GoncaloRibeiro6533/Access-Control-System/docs/moduloKeyboardReader_LEIC21D_G06.pdf

Keyboard Reader (Access Control System)
Laboratório de Informática e Computadores 2022 / 2023 verão Autores: António Coelho 47236 / Gonçalo Ribeiro 48305/ Jorge Silva 49504

O módulo Keyboard Reader é constituído por três blocos principais: i) o descodificador de teclado (Key Decode); ii) o bloco de armazenamento (designado por Ring Buffer); e iii) o bloco de entrega ao consumidor (designado por Output Buffer). Neste caso o módulo Control, implementado em software, é a entidade consumidora.

Figura 1 – Diagrama de blocos do módulo Keyboard Reader

## 1 Key Decode

O bloco Key Decode implementa um descodificador de um teclado matricial 4x3 por hardware, sendo constituído por três sub-blocos: i) um teclado matricial de 4x3; ii) o bloco Key Scan, responsável pelo varrimento do teclado; e iii) o bloco Key Control, que realiza o controlo do varrimento e o controlo de fluxo, conforme o diagrama de blocos representado na Figura 2a. O controlo de fluxo de saída do bloco Key Decode (para o módulo Key Buffer), define que o sinal Kval é ativado quando é detetada a pressão de uma tecla, sendo também disponibilizado o código dessa tecla no barramento K0:3. Apenas é iniciado um novo ciclo de varrimento ao teclado quando o sinal Kack for ativado e a tecla premida for libertada. O diagrama temporal do controlo de fluxo está representado na Figura 2b.

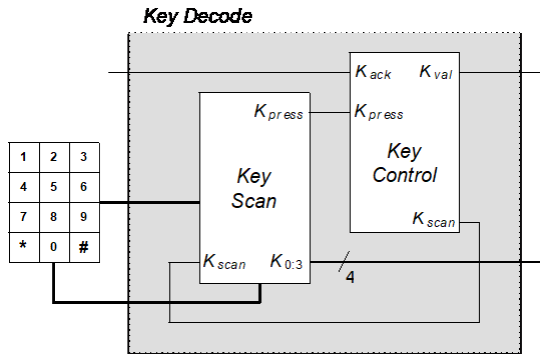
[picture p6: figure]

a) Diagrama de blocos
b) Diagrama temporal
Figura 2 – Bloco Key Decode O bloco Key Scan foi implementado de acordo com o diagrama de blocos representado na Figura 3. Na implementação do bloco Key Scan optámos pelo diagrama de blocos versão 1, uma vez que na versão 2 o Kpress fica ativo, se uma tecla for premida, independentemente da linha que esteja a ser observada.
Na versão 1, de acordo com a figura 3 este é constituído por um decoder (2 por 3), um mutiplexer (4 por 1) e um contador de 4 bits que é responsável pela seleção das saídas do decoder e das entradas do mutiplexer.
Às entradas do mutiplexer estão ligadas as linhas do teclado de forma a ativar o Kpress quando uma tecla na linha selecionada seja premida. Nas saídas do decoder encontram-se as colunas do teclado, de forma a selecionar uma linha. Quando uma tecla é premida a entrada enable do contador recebe o valor lógico 0, para que seja possível fazer a leitura do código da tecla premida, sendo os bits de maior peso a coluna da tecla foi premida e os bits de menor peso a linha da tecla premida.

O bloco Key Control foi implementado pela máquina de estados representada em ASM-chart na Figura 4.

No estado 00 o Kscan está ativo de forma a fazer o varrimento do teclado até que uma tecla seja premida, sendo essa avaliação feita através do sinal Kpress. Quando uma tecla é premida entramos no estado 01 e o sinal Kval fica ativo indicando que foi pressionada uma tecla válida, e mantém-se neste estado até que o sinal Kack fique ativo indicando que a leitura do código da tecla está completa e foi aceite. Quando Kack ficar ativo saímos do estado e entramos no estado 10, a aguardar que o sinal Kack e o sinal Kpress estejam desativados de forma que apenas seja iniciado um novo varrimento do teclado quando o sinal Kack esteja desativado e a tecla premida for libertada.

A descrição hardware do bloco Key Decode em VHDL encontra-se no Anexo A.

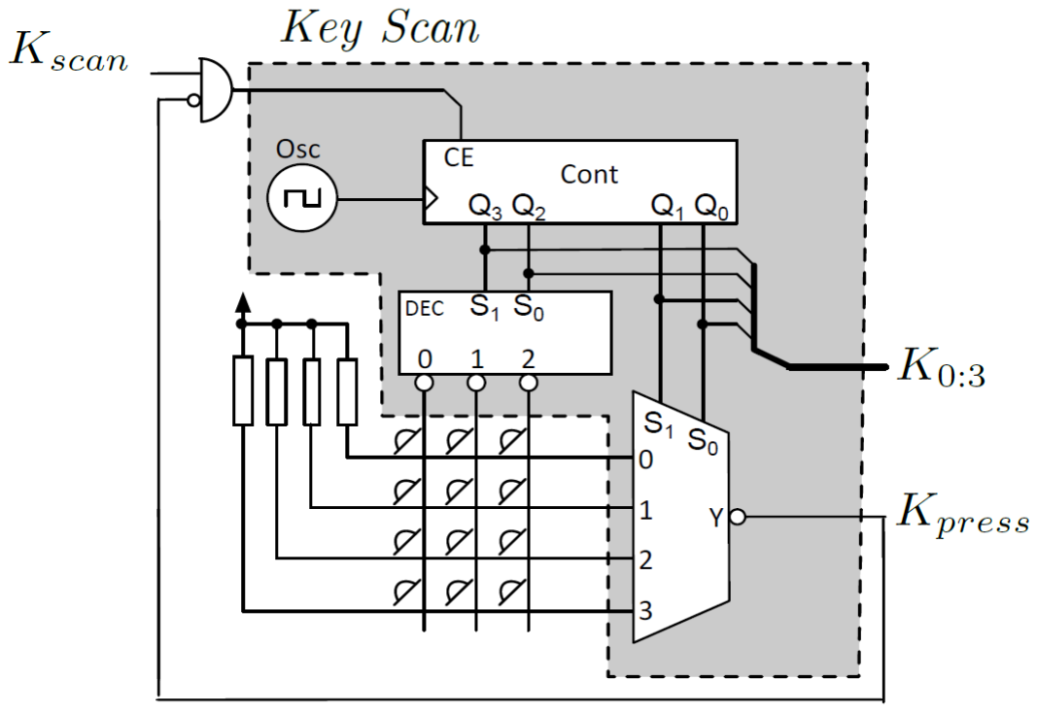
[picture p7: figure]

Figura 3 - Diagrama de blocos do bloco Key Scan

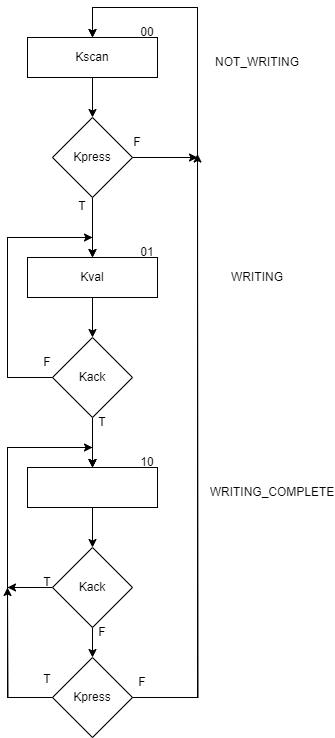
[picture p8: figure]

Figura 4 – Máquina de estados do bloco Key Control
Com base nas descrições do bloco Key Decode implementou-se parcialmente o módulo Keyboard Reader de acordo com o esquema elétrico representado no Anexo D.

## 2 Ring Buffer

O bloco RingBuffer é uma estrutura de dados para armazenamento de teclas com disciplina FIFO (First In First Out), com capacidade de armazenar até oito palavras de quatro bits. A escrita de dados no Ring Buffer inicia-se com a ativação do sinal DAV (Data Available) pelo sistema produtor, neste caso pelo Key Decode, indicando que tem dados para serem armazenados. Logo que tenha disponibilidade para armazenar informação, o Ring Buffer escreve os dados D0:3 em memória. Concluída a escrita em memória ativa o sinal DAC (Data Accepted) para informar o sistema produtor que os dados foram aceites. O sistema produtor mantém o sinal DAV ativo até que DAC seja ativado. O Ring Buffer só desativa DAC depois de DAV ter sido desativado .A implementação do Ring Buffer é baseada numa memória RAM (Random Access Memory). O endereço de escrita/leitura, selecionado por

## pppppp

gggg é definido pelo bloco Memory Address Control

(MAC) composto por dois registos, que contêm o endereço de escrita e leitura, designados por putIndex e getIndex respetivamente. O MAC suporta assim ações de incPute incGet, gerando informação se a estrutura de dados está cheia (Full) ou se está vazia (Empty). O bloco Ring Buffer procede à entrega de dados à entidade consumidora, sempre que esta indique que está disponível para receber, através do sinal Clear To Send(CTS). Na Figura 5 é apresentado o diagrama de blocos para uma estrutura do bloco Ring Buffer.

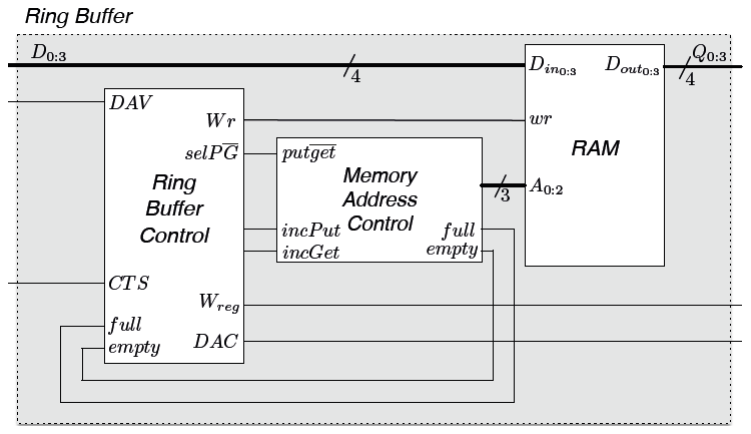
[picture p9: figure]

Figura 5 Diagrama de blocos do bloco Ring Buffer
No desenvolvimento do bloco Ring Buffer começou-se por desenvolver o bloco Memory Address Control de acordo com as informações fornecidas. Desta forma foi necessário recorrer a 2 contadores de 3 bits, uma vez que a RAM presente no diagrama de blocos tem 8 endereços disponíveis, para incrementar os endereços de leitura e escrita designados por putIndex e getIndex respetivamente. Para gerar a informação dos sinais Full e Empty foi usado um contador cresecente/decrescente que opera quando o MAC recebe os sinais incput ou incGet, a contagem crescente ou decrescente é determinada pelo sinal incPut sendo crescente quando este tem o valor lógico ‘1’ e decrescente quando tem o valor lógico ‘0’, de forma a acompanhar o número de endereços ocupados com informação que não foi enviada para leitura.
Os endereços de leitura e escrita são fornecidos à RAM por um mutiplexer 2 por 1, onde a seleção da entrada recebe o sinal ppppppgggg, quando este tem o valor lógico ‘0’

é enviado o idxGet e quando este apresenta o valor lógico ‘1’ é enviado o idxPut.
Em baixo encontra-se o diagrama de blocos do bloco MAC.

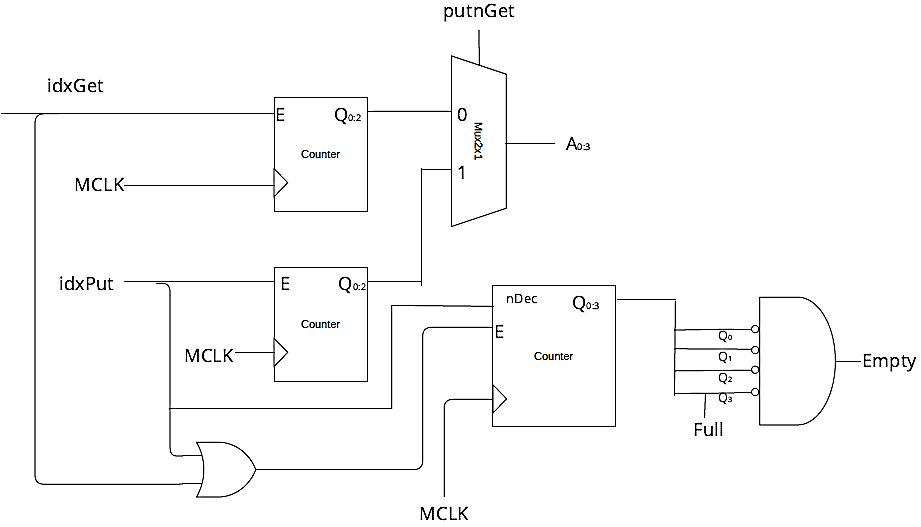
[picture p10: figure]

Figura 6 Diagrama de blocos do bloco MAC
O bloco Ring Buffer Control foi implementado pela máquina de estados representada em ASM-chart na Figura 7.
No estado 00 aguarda-se uma instrução de escrita ou leitura, no caso da instrução recebida seja de escrita, com a ativação do sinal DAV, é verificando antes de realizar a escrita na RAM, se esta tem algum endereço disponível para armazenar dados. Se os endereços da RAM estiverem todos ocupados, entramos no estado 10 onde é realizada uma espera pela ativação do sinal CTS, de forma a realizar uma leitura da RAM, libertando espaço de forma a concluir a instrução de leitura. Quando o sinal CTS estiver ativo, ocorre a passagem para o estado 101, onde é ativado o sinal Wreg de forma a registar os dados lidos. Depois de enviar os dados para o bloco Output Buffer no estado 111 o sinal incGet é ativado de forma a incrementar o idxGet e verifica-se se estava a ser executada uma instrução de escrita, de forma a concluir a mesma. A instrução de escrita é realizada ativando o sinal selPG de forma a fornecer o endereço á RAM, no estado seguinte é ativado o sinal Wr de forma a escrever os dados recebidos na RAM, depois da escrita é incrementado o idxPut com a ativação do sinal incPut e a seguir passamos para o estado 110 onde o sinal DAC é ativado de forma a informar o bloco Key Decode que os dados recebidos foram aceites.
No caso de o sinal full não esteja ativo é realizada a instrução de escrita, sem realizar uma instrução de leitura. Quando sinal DAV não estiver ativo, mas o sinal CTS tenha o valor lógico 1, verifica-se se a RAM está vazia através do sinal empty. Se a RAM não tem dados para leitura mantêm-se no estado 00, caso contrário ocorre a passagem para o estado 101 e é realizada a operação de leitura tal como descrita anteriormente.

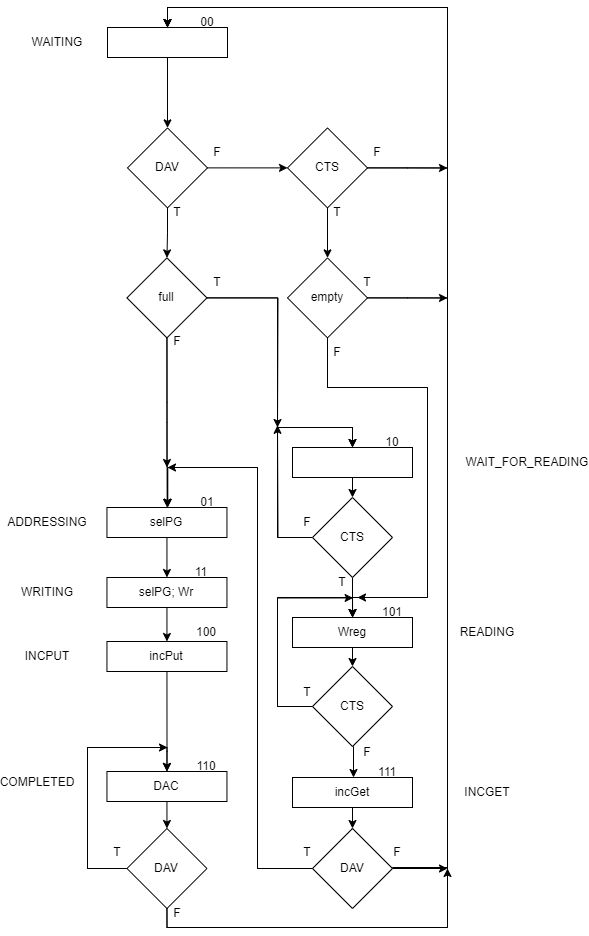
[picture p11: figure]

Figura 7 Máquina de estados do bloco Ring Buffer Control

A descrição hardware do bloco Ring Buffer em VHDL encontra-se no Anexo B.

## 3 Output Buffer

O bloco Output Buffer do Keyboard Reader é responsável pela interação com o sistema consumidor, neste caso o módulo Control. O Output Buffer indica que está disponível para armazenar dados através do sinal OBfree. Assim,nesta situação o sistema produtor pode ativar o sinal Load para registar os dados. O Control quando pretende ler dados do Output Buffer, aguarda que o sinal Dval fique ativo, recolhe os dados e pulsa o sinal ACK indicando que estes já foram consumidos. O Output Buffer, logo que o sinal ACK pulse, deve invalidar os dados baixando o sinal Dval e sinalizar que está novamente disponível para entregar dados ao sistema consumidor, ativando o sinal OBfree. Na Figura 8, é apresentado o diagrama de blocos do Output Buffer.

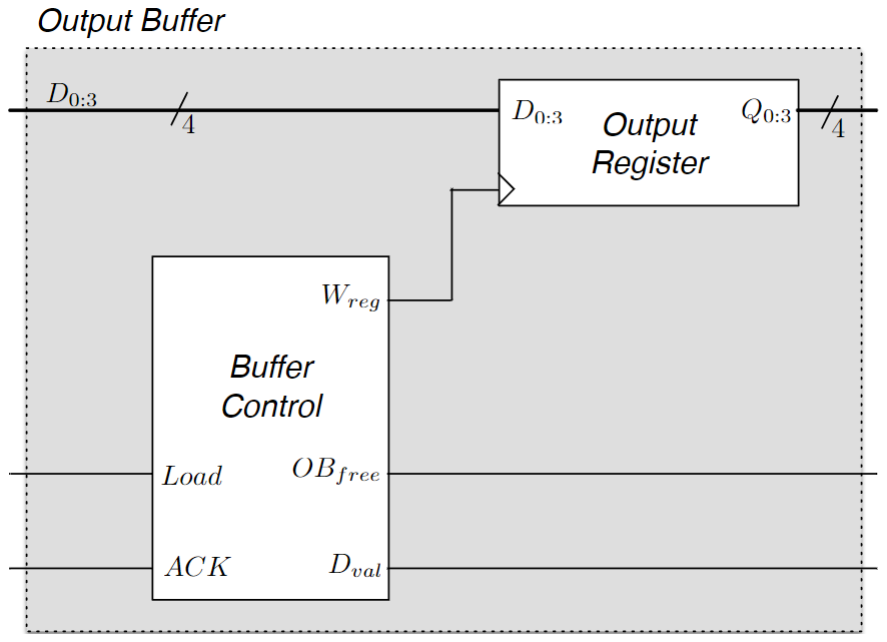
[picture p12: figure]

Figura 8 Diagrama de blocos do bloco Output Buffer Sempre que o bloco emissor Ring Buffer tenha dados disponíveis e o bloco de entrega Output Buffer esteja disponível (OBfree ativo), o Ring Buffer realiza uma leitura da memória e entrega os dados ao Output Buffer ativando o sinal Wreg. O Output Buffer indica que já registou os dados desativando o sinal OBfree.

O bloco Buffer Control foi implementado pela máquina de estados representada em ASM-chart na Figura 8.

A máquina de estados do bloco Buffer Control inicialmente encontra-se no estado 00, com o sinal OBfree indicando que está disponível para receber dados, quando o sinal Load tiver o valor lógico ‘1’ (indicando que o bloco Ring Buffer tem dados para entregar) ocorre a passagem para o estado 01 onde o sinal Wreg é ativado de forma a realizar a escrita no bloco Output Register e a seguir ocorre a passagem para o estado 10 onde o sinal Dval é ativado (informando o Control de que tem dados disponíveis para recolha) e mantém-se ativo até que o sinal ACK tenha o valor lógico ‘1’, indicando que os dados foram consumidos pelo Control. Por fim invalida os dados baixando o sinal Dval e sinalizar que está novamente disponível para entregar dados ao sistema consumidor, ativando o sinal OBfree.

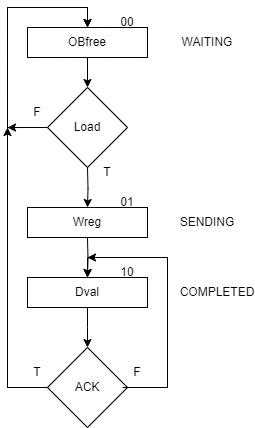
[picture p13: figure]

A descrição hardware do bloco Output Buffer em VHDL encontra-se no Anexo C.

## 4 Interface com o Control

Implementou-se o módulo Control em software, recorrendo a linguagem Kotlin e seguindo a arquitetura lógica apresentada na Figura 8.

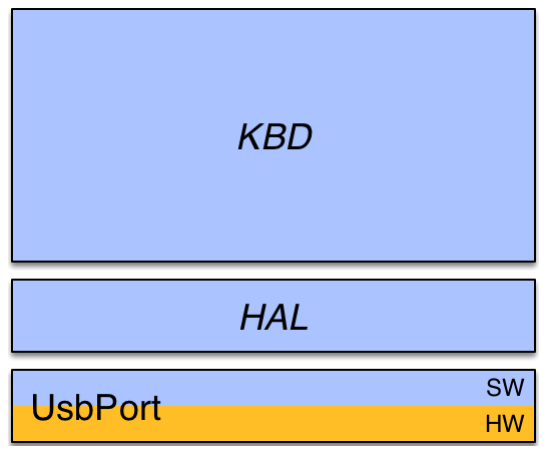
[picture p14: figure]

Figura 10 – Diagrama lógico do módulo Control de interface com o módulo Keyboard Reader

HAL e KBD desenvolvidos são descritos nas secções 3.1. e 3.2, e o código fonte desenvolvido nos Anexos C e D, respetivamente.

Figura 9 Máquina de estados do bloco Buffer Control

## 4.1 HAL

A classe HAL é responsável por comunicar com o bloco UsbPort, fazendo a leitura e a escrita no bloco UsbPort. De forma a evitar efetuar a leitura do bloco UsbPort repetidamente foi criada uma variável global (written) dentro da classe para guardar o último valor escrito.
Nesta classe temos a função init que inicia a classe, a função isBit() que retorna true se o bit passado na máscara tiver o valor lógico 1. A função readBits() efetua uma leitura tal como a função isBit() mas para um conjunto de bits.
A função writeBits() escreve um valor num conjunto de bits, a função setBits() escreve nos bits da máscara o valor lógico
1. E a função clrBits() coloca o valor lógico 0 no bit indicado na máscara.

## 4.2 KBD

Esta classe utiliza a classe HAL de forma a obter do bloco UsbPort um código de uma tecla e retornar o char equivalente ao código lido.
Nesta classe temos uma lista com os Char´s correspondentes aos códigos possíveis, temos a função getKey() que retorna o char correspondente ao código da tecla premida imediatamente, quando o sinal Dval do bloco Output Buffer estiver ativo e ativa o sinal ACK do bloco

Control informando que os dados foram recebidos . E por fim temos a função waitKey() que retorna o char correspondente ao código da tecla premida ao fim de um intervalo de tempo ou NONE se não for premida nenhuma tecla.

## 5 Conclusões

O objetivo deste módulo é descodificar a tecla pressionada e enviar o respetivo código para o Control. Para isso, utilizamos funções previamente desenvolvidas para leitura de portas, que convertem o código recebido em caracter de forma a descodificar a tecla premida. Para além das funções dos objetos KBD e HAL, foi necessário realizar um contador que efetuasse a soma com o resultado presente nas suas saídas, por essa razão foi implementado um register que coloca o valor da saída do contador numa das entradas do mesmo, tendo em conta que em uma das entradas é introduzido o valor 1. Em relação ao software, este foi testado no simulador e aparenta ter um funcionamento correto, e os módulos Key Decode, Ring Buffer e Output Buffer também foram testados, primeiro no simulador e depois na placa onde mostraram um funcionamento correto.

## A. Descrição VHDL do bloco Key Decode Key Scan

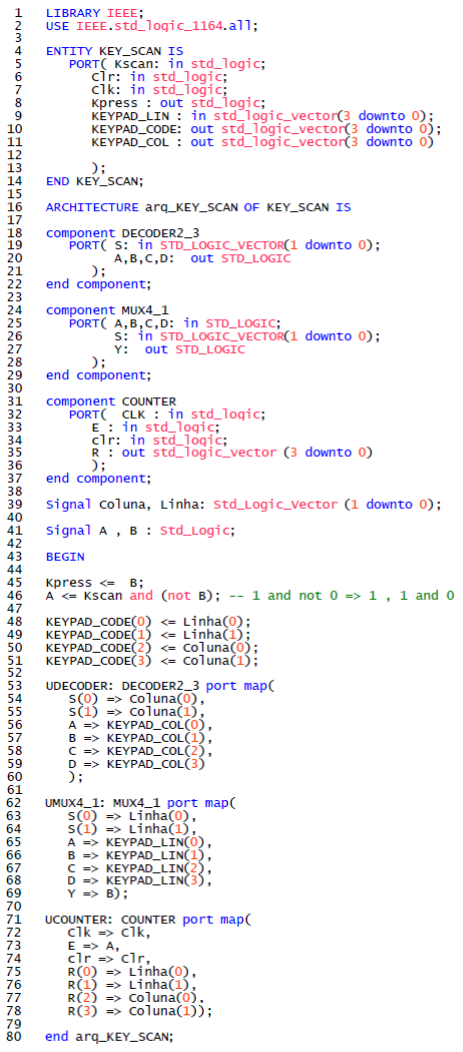
[picture p15: figure]

## Key Control

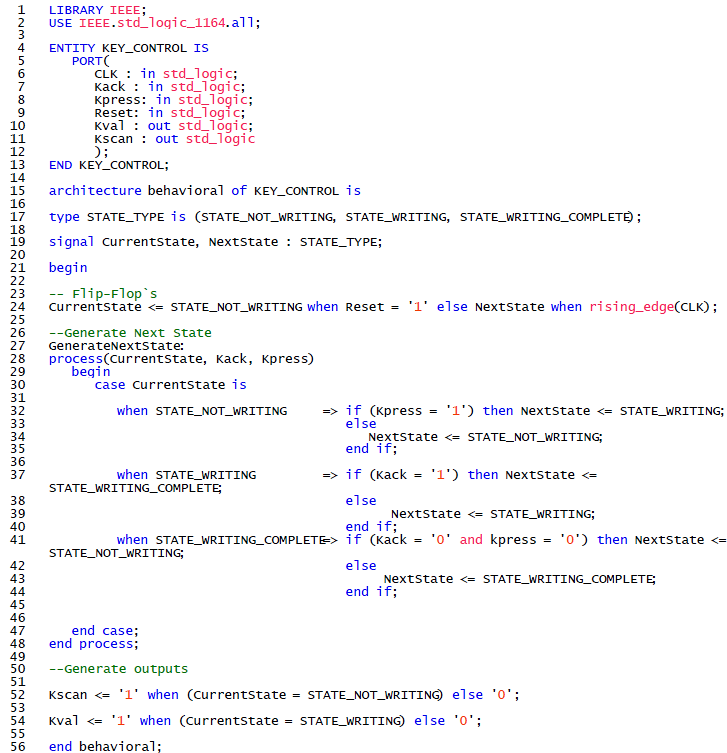
[picture p16: figure]

## Key Decode

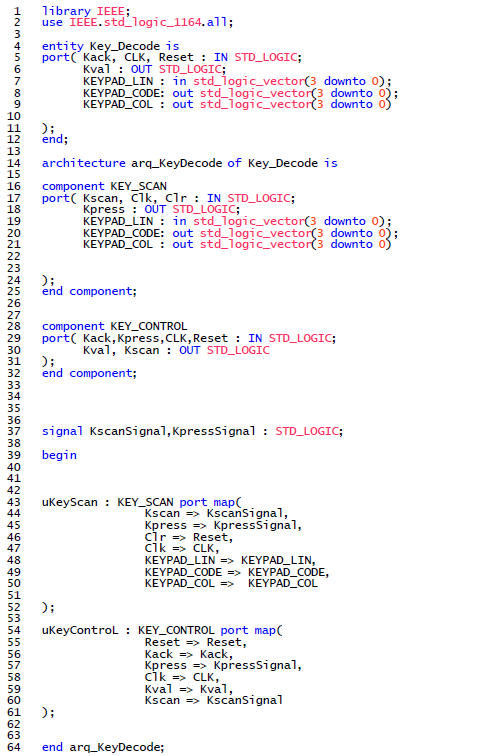
[picture p17: figure]

## B. Descrição VHDL do bloco Ring Buffer

## Ring Buffer Control

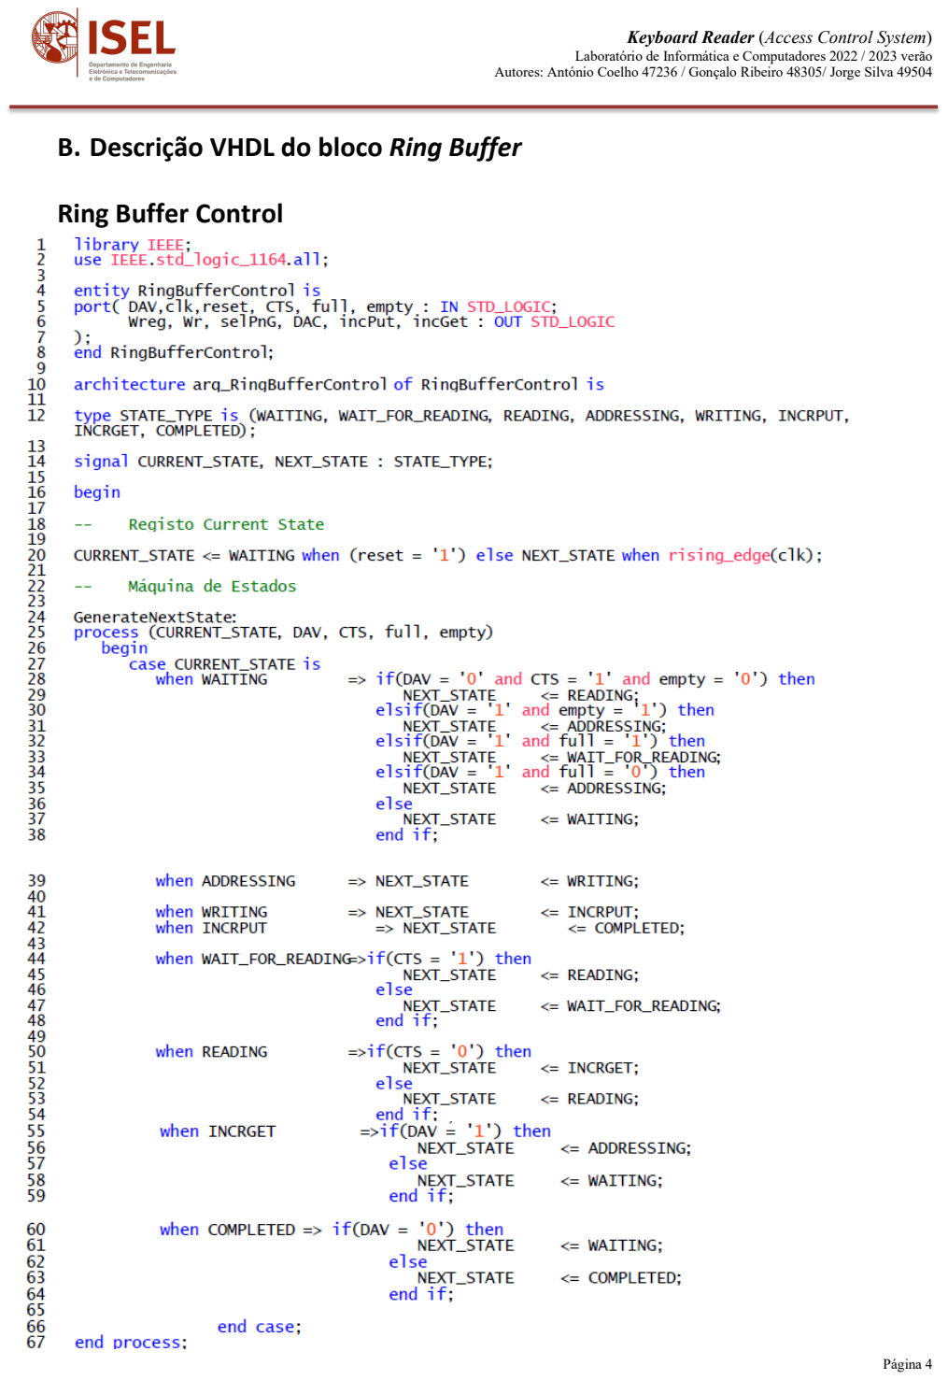
[picture p18: page 9]

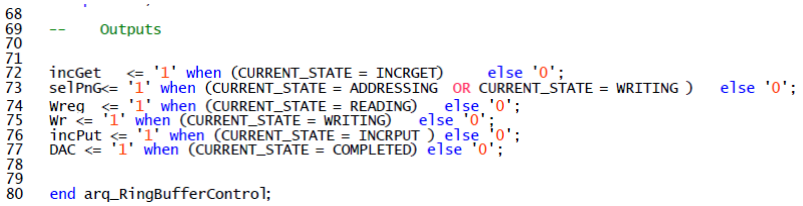
[picture p19: figure]

## Memory Address Control

## Contador de 3 bits

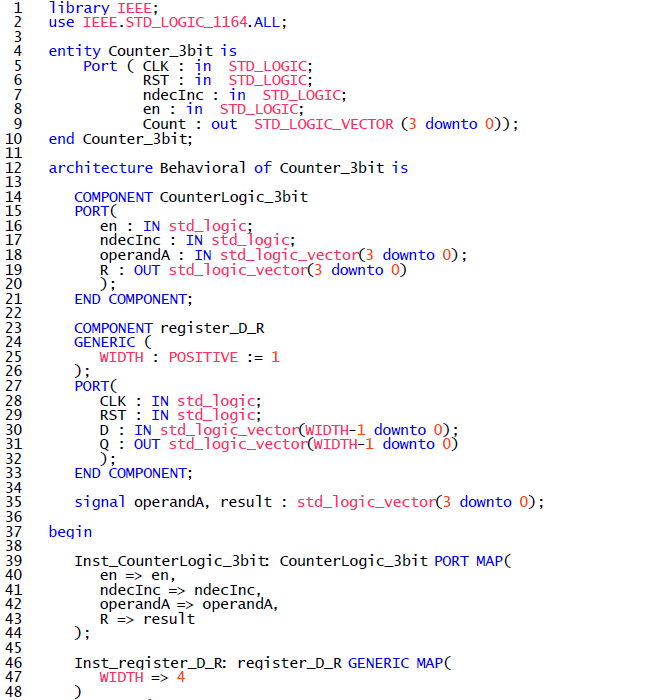
[picture p20: figure]
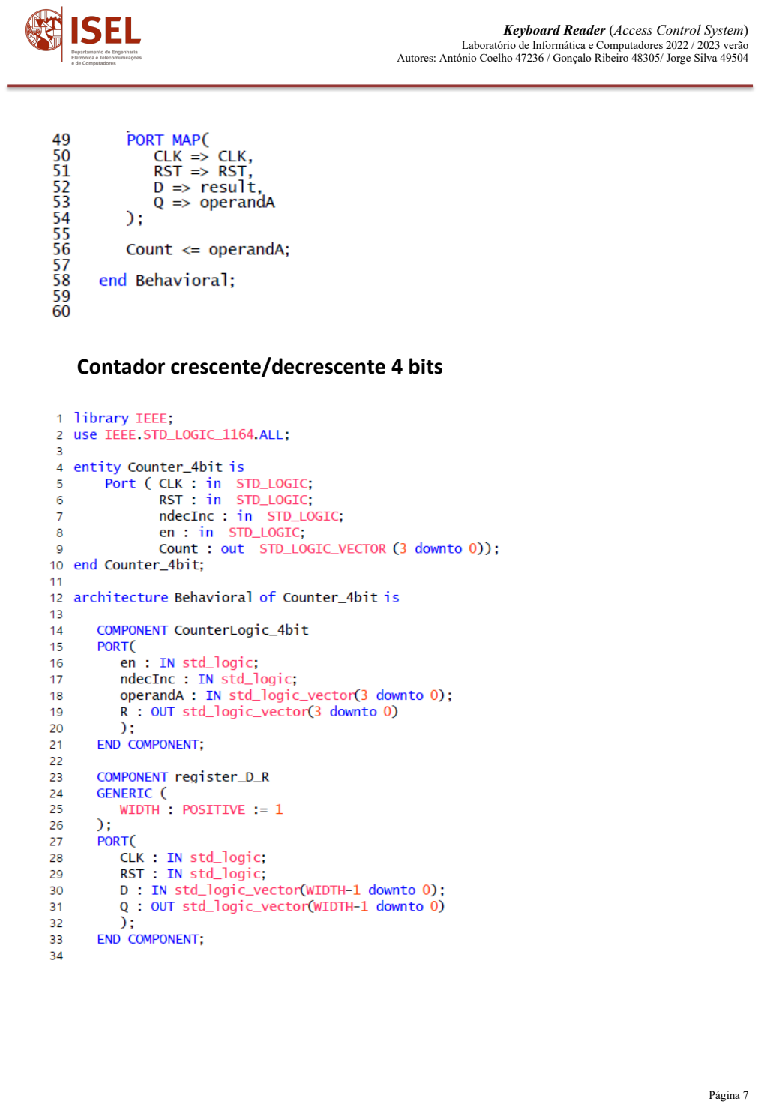
[picture p21: page 12]

## Contador crescente/decrescente 4 bits

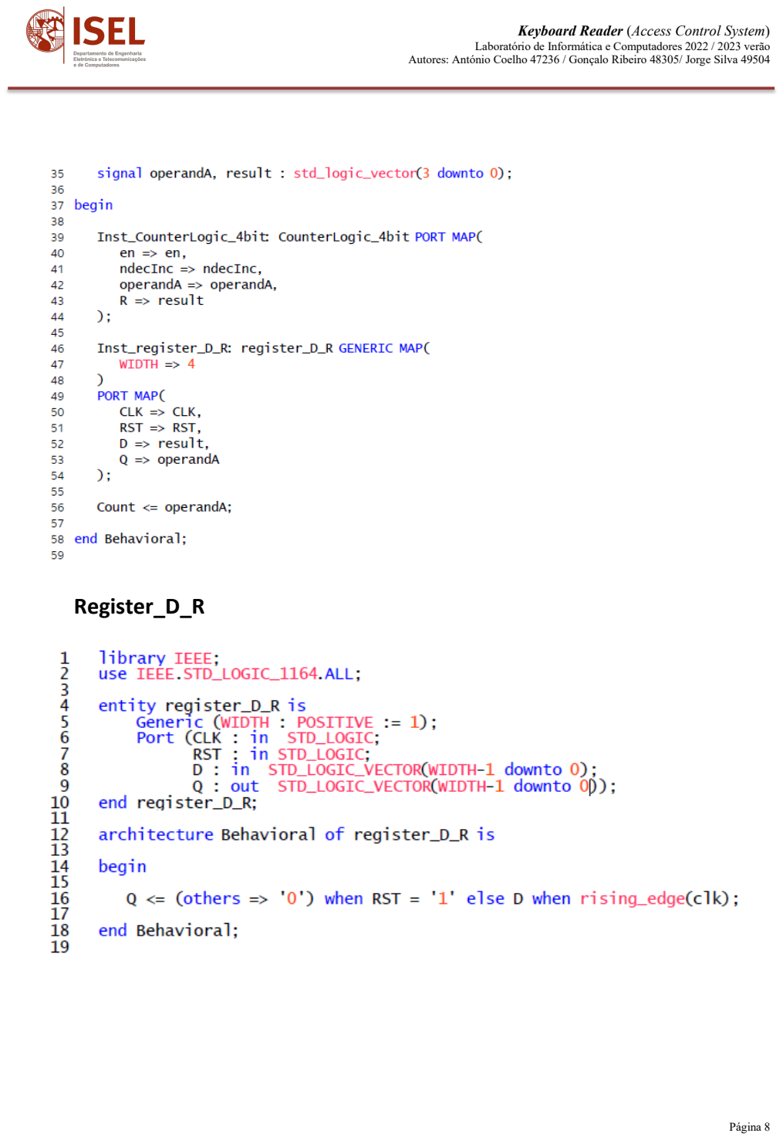
[picture p22: page 13]

## Register_D_R

## Multiplexer 2x1

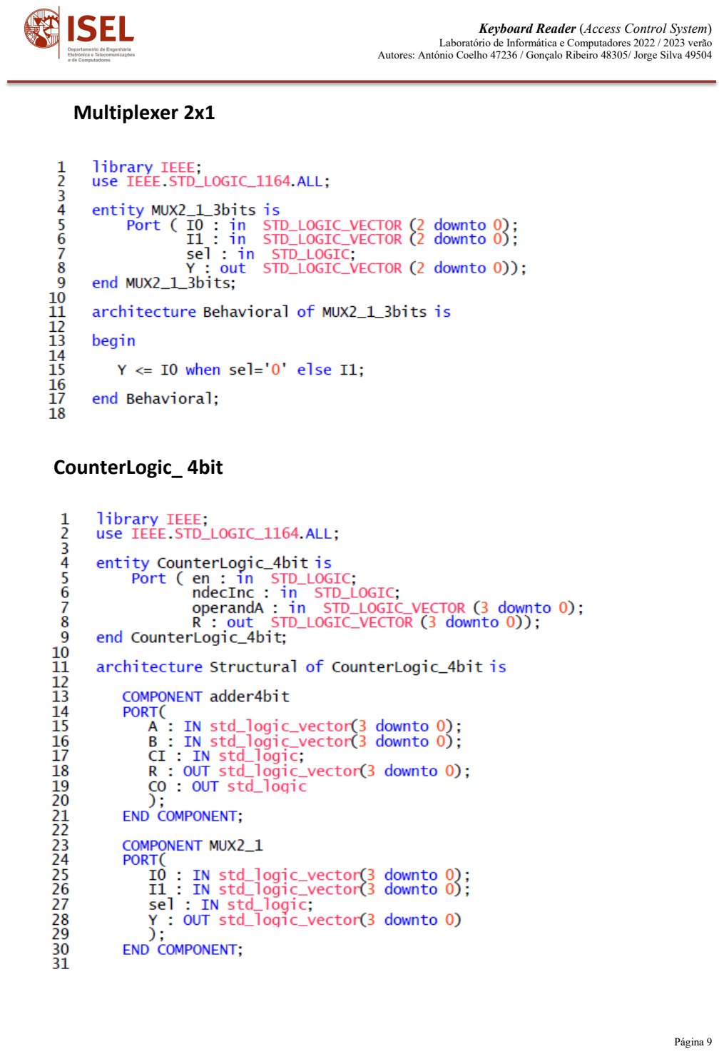
[picture p23: page 14]

## CounterLogic_ 4bit

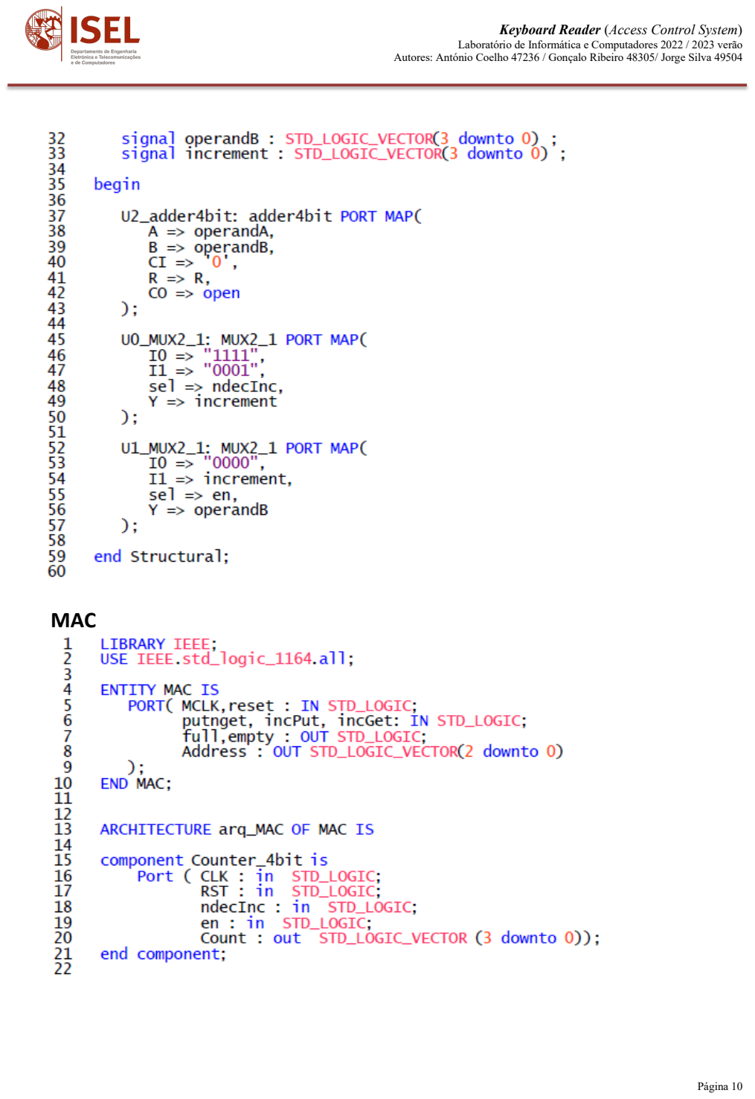
[picture p24: page 15]

## MAC

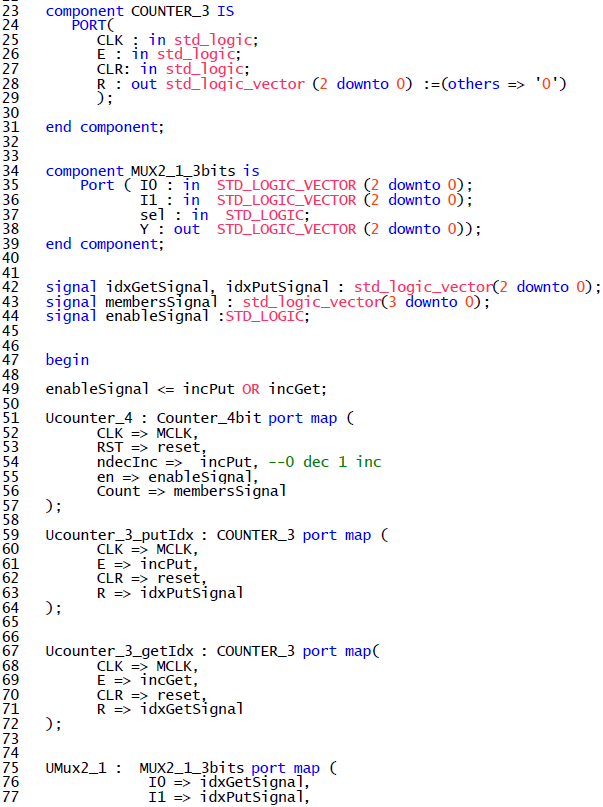
[picture p25: figure]

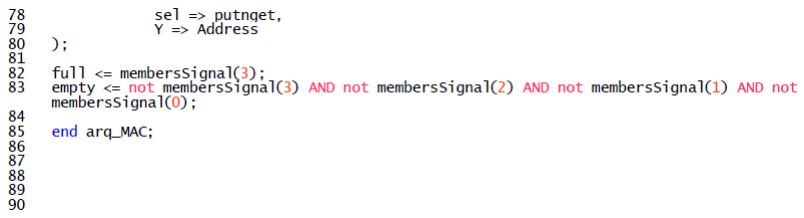
[picture p26: figure]

## C. Descrição VHDL do bloco Output Buffer

## Output Buffer Control

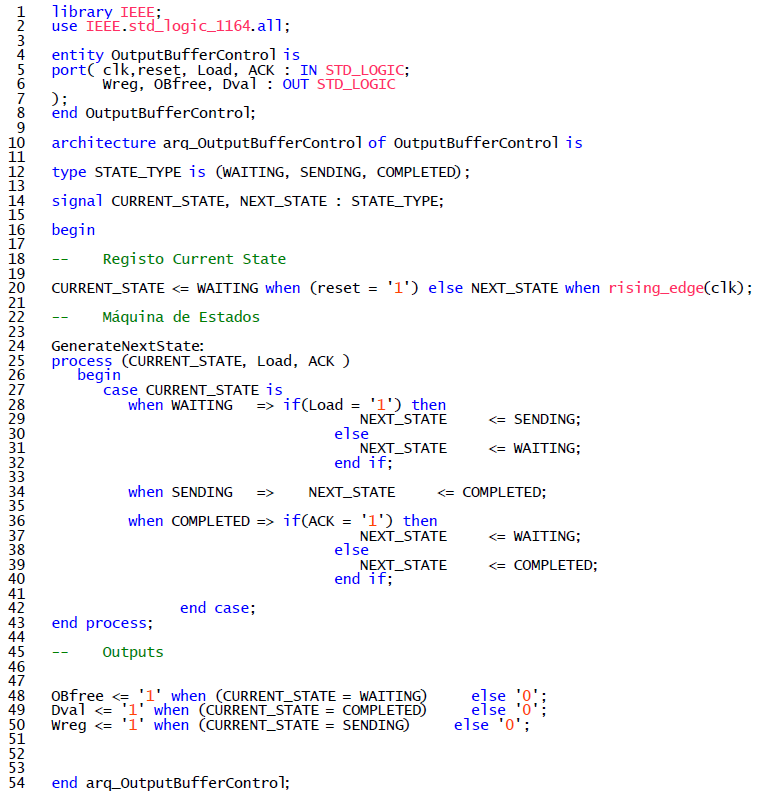
[picture p27: figure]

## Registor

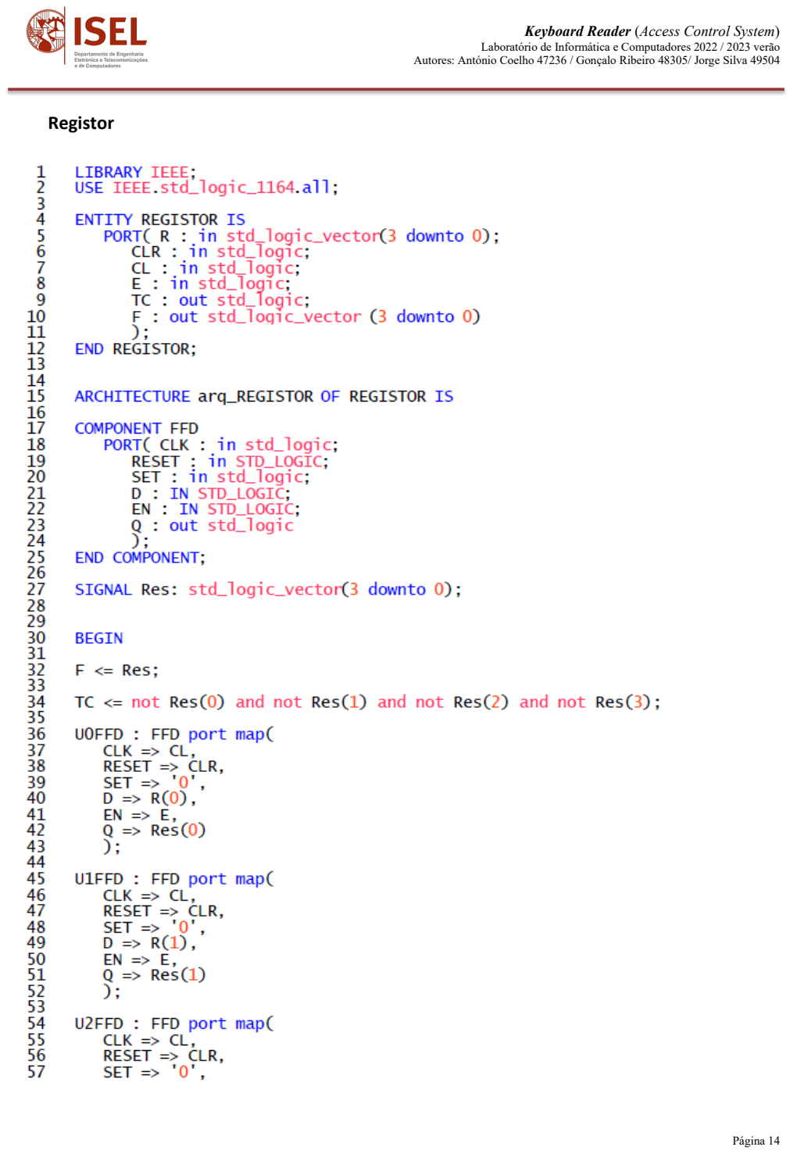
[picture p28: page 19]
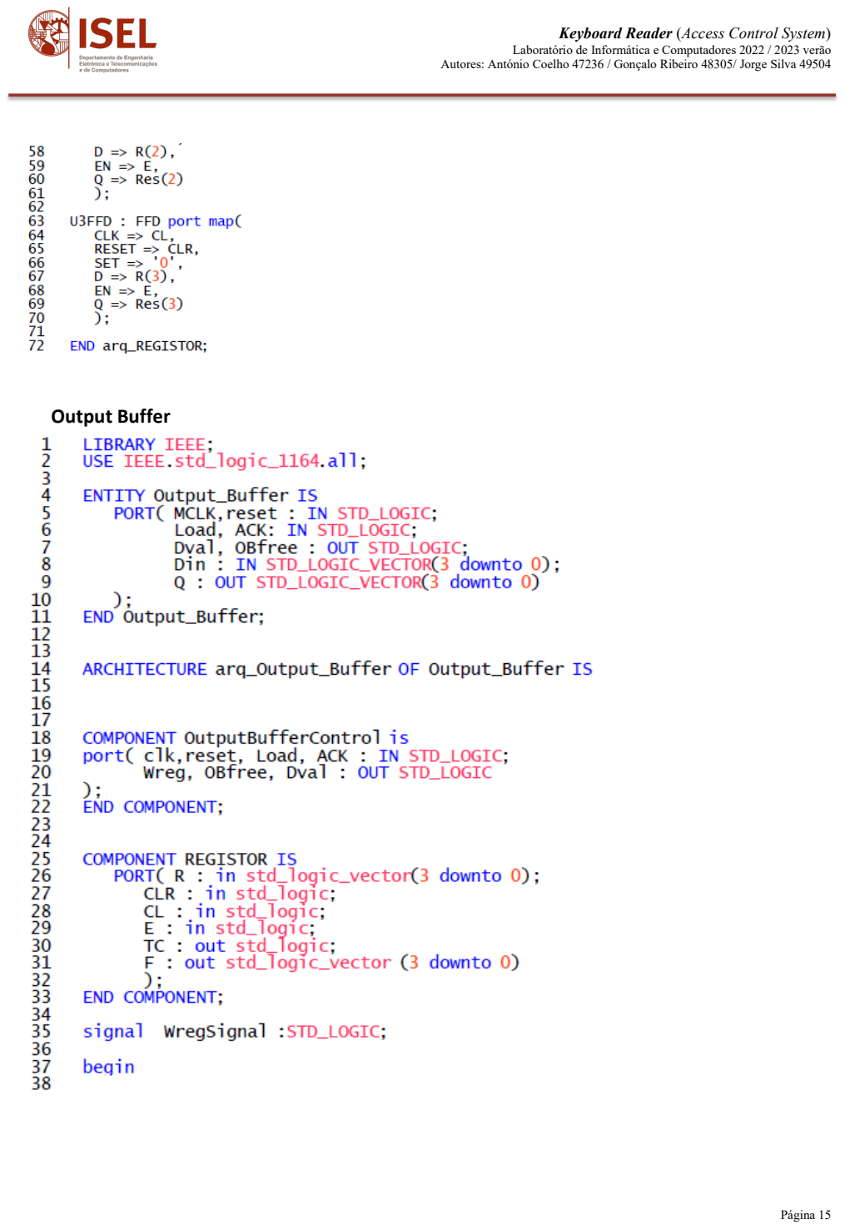
[picture p29: page 20]

## Output Buffer

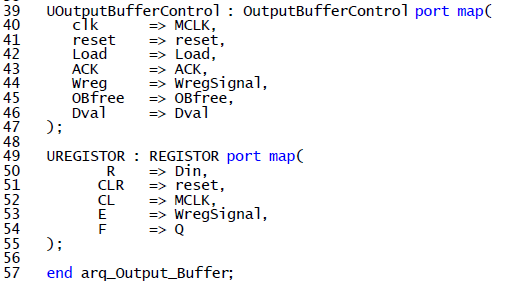
[picture p30: figure]

## Keyboard Reader

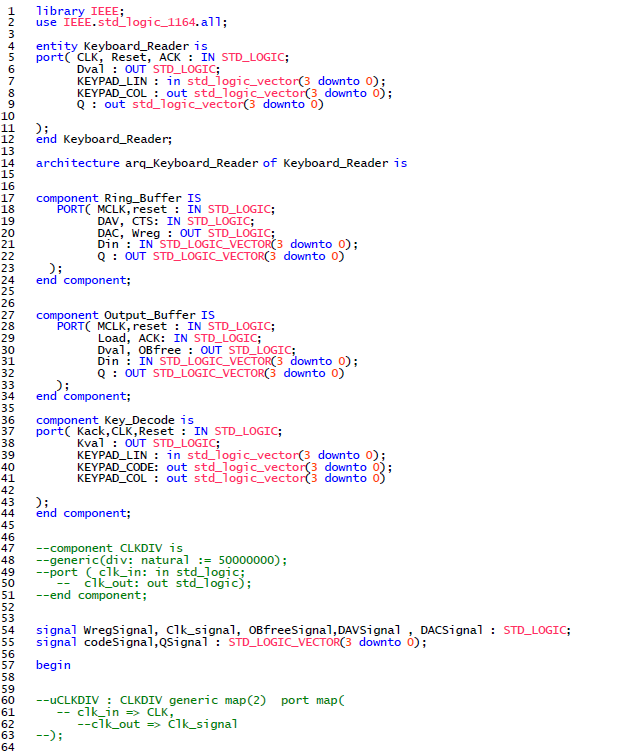
[picture p31: figure]

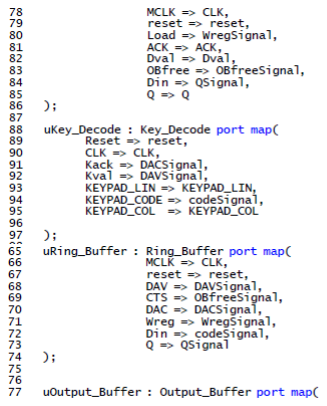
[picture p32: figure]

## D. Descrição VHDL do bloco KeyboardReaderUSBPORT

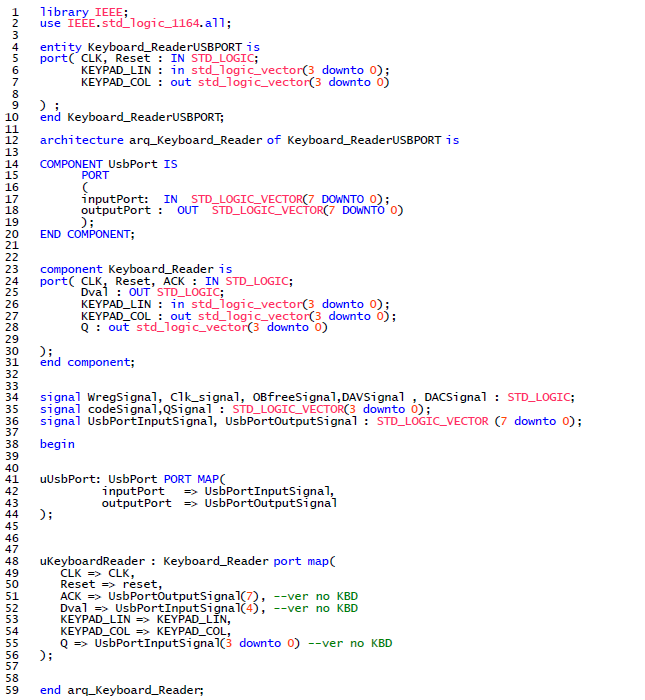
[picture p33: figure]

## E. Atribuição de pinos do módulo Keyboard_ReaderUSBPORT

#============================================================

# CLOCK

#============================================================

set_location_assignment PIN_P11 -to CLK #============================================================ #SWITCHES
#============================================================ set_location_assignment PIN_C10 -to Reset #========================================================== set_location_assignment PIN_W5 -to KEYPAD_LIN[0] set_location_assignment PIN_AA14 -to KEYPAD_LIN[1] set_location_assignment PIN_W12 -to KEYPAD_LIN[2] set_location_assignment PIN_AB12 -to KEYPAD_LIN[3] set_location_assignment PIN_AB11 -to KEYPAD_COL[0] set_location_assignment PIN_AB10 -to KEYPAD_COL[1] set_location_assignment PIN_AA9 -to KEYPAD_COL[2] set_location_assignment PIN_AA8 -to KEYPAD_COL[3] #============================================================ # End of pin and io_standard assignments #============================================================

## F. Código Kotlin - HAL

object HAL {
var written = 0b0000_0000
private var ACTIVE = false
fun init() { // Inicia a classe if(!ACTIVE) {
UsbPort.write(written)
ACTIVE=true
}
}

// Retorna true se o bit tiver o valor lógico ‘1’
fun isBit(mask: Int): Boolean = (mask and UsbPort.read()) != 0

// Retorna os valores dos bits representados por mask presentes no UsbPort fun readBits(mask: Int): Int = mask and UsbPort.read()

// Escreve nos bits representados por mask o valor de value
/**
* value -> 0000_1001.
* mask -> 0000_1111.
* lastWritten -> 1111_0111.
* new lastWritten -> 1111_1001.
* 1º: (value and mask) -> 0000_1001 sets the bits in value to be written to the ones in the mask.
* 2º: (lastWritten and mask.inv()) -> 1111_0000 sets the bits in lastWritten that are not in the mask,this operation
* sets to 0 all the bits in lastWritten that are not in the mask, preparing it to receive the updated value.
* 3º: (value and mask) or (lastWritten and mask.inv()) -> 0000_1001 or 1111_0000 -> 1111_1001 sets the bits in
* lastWritten that are in the mask to the corresponding bits in value and keeps the bits that are not in the mask unchanged.
*/

fun writeBits(mask: Int, value: Int) {
| written = (value and mask) or (written and mask.inv()) UsbPort.write(written)

}

// Coloca os bits representados por mask no valor lógico ‘1’ fun setBits(mask: Int) {
| written = (written or mask) UsbPort.write(written)

}

// Coloca os bits representados por mask no valor lógico ‘0’ fun clrBits(mask: Int) {
| written = written and mask.inv() UsbPort.write(written)

}

}

## G. Código Kotlin - KBD

//
/**
* Mapeamento das teclas do teclado matricial 4x4:
* | Key Column 1 | Key Column 2 | Key Column 3
*Row 1 | 1 | 0x00 | 2 | 0x04 | 3 | 0x08
*Row 2 | 4 | 0x01 | 5 | 0x05 | 6 | 0x09
*Row 3 | 7 | 0x02 | 8 | 0x06 | 9 | 0x0A
*Row 4 | * | 0x03 | 0 | 0x07 | # | 0x0B
**/

//Read keys. Methods return '0'..' 9','#','*' or NONE. object KBD {
const val NONE = 0.toChar()
const val DATA = 0x0F //UsbPort.I0..3
const val MASK_DVAL = 0x10 //UsbPort.I4
const val MASK_ACK = 0x80 //UsbPort.O7
private val KEYS : List<Char> = listOf('1', '4', '7', '*', '2', '5', '8', '0', '3', '6', '9', '#')
// 0 | 1 | 2 | 3 | 4 | 5 | 6 | 7 | 8 | 9 | 10
11
// Starts the class.
fun init() {
HAL.init()
}
// Returns the pressed or NONE key immediately if there is no key pressed. fun getKey(): Char {
if (HAL.isBit(MASK_DVAL)) {
val a = HAL.readBits(DATA)
return if (a in 0..11) {
HAL.setBits(MASK_ACK)
HAL.clrBits(MASK_ACK)
KEYS[a]

} else NONE
}
return NONE
}
// Returns when the key is pressed or NONE after millisecond timeout has elapsed. fun waitKey(timeout: Long): Char {
var time = timeout
while (time > 0) {
val serial = getKey()
if (serial != NONE) return serial Thread.sleep(1)
time--
}
return NONE
}

}
