GoncaloRibeiro6533/Access-Control-System/docs/moduloSerialDoorController_LEIC21D_G06.pdf

Serial Door Controller (Access Control System)
Laboratório de Informática e Computadores 2022 / 2023 verão Autores: António Coelho 47236/ Gonçalo Ribeiro 48305 / Jorge Silva 49504

O módulo de interface com o mecanismo da porta(Serial Door Controller, SDC) implementa a receção em série da informação enviada pelo módulo de controlo, entregando-a posteriormente ao mecanismo da porta, conforme
representado | na | Figura | 1.

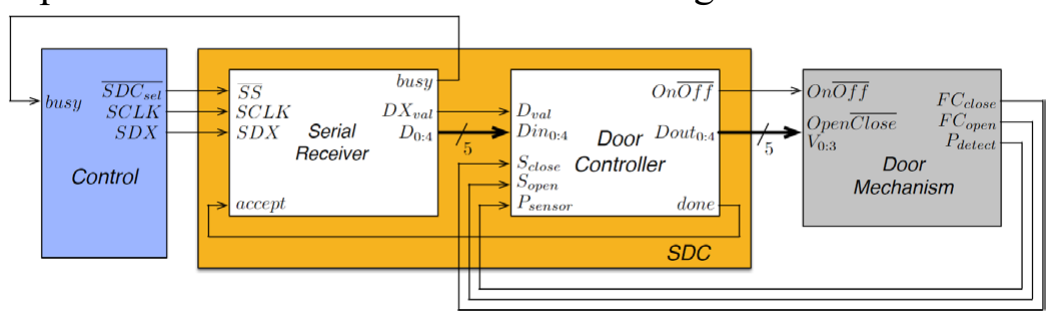
[picture p34: figure]

Figura 1 – Diagrama de blocos do módulo Serial Door Controller

## 1 Serial Receiver

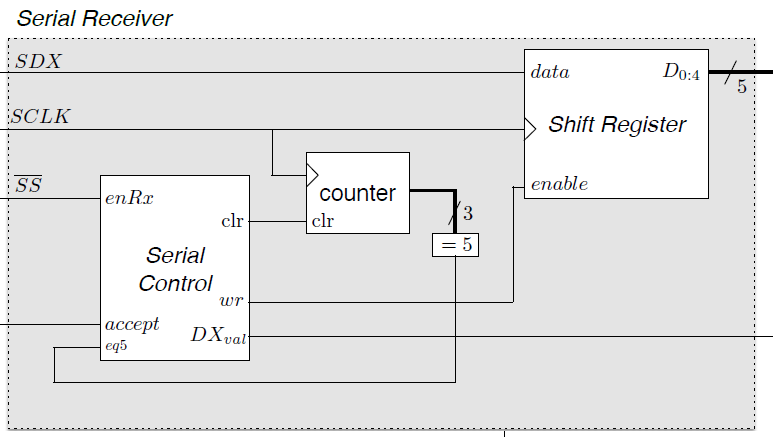
[picture p35: figure]

Figura 2 – Diagrama de Blocos do bloco Serial Receiver O bloco Serial Receiver é utilizado tanto no módulo Serial LCD Controller como no módulo Serial Door Controller, desta forma foi possível reutilizar o bloco Serial Receiver nos dois módulos.

O SDCrecebe em série uma mensagem constituída por cinco bits de informação. A comunicação com o SDC realiza-se, tendo como primeiro bit de informação, o bit OOOOOOOO

# CCCCCCCC

(OC) que indica se o comando é para abrir ou fechar a porta. Os restantes bits contêm a informação da velocidade de abertura ou fecho. O SDC indica que está disponível para a receção de uma nova trama após ter processado a trama anterior, colocando o busy no nível lógico “0”.

O bloco Serial Control foi implementado pela máquina de estados representada em ASM-chart na Figura 3.

Inicialmente o Serial Control encontra-se estado 00 o sinal Clr está ativo de forma que o counter permaneça inativo até que o valor lógico do sinal SS seja 0 indicando que o envio de dados irá começar. Enquanto permanece no estado 01 o sinal WR fica ativo e permanece ativo até que sejam contados 5 bits na transferência de dados. Quando o número de bits recebidos atinge o valor 5 ocorre uma passagem para o estado 10, e permanece neste até que o sinal SS esteja com o valor lógico 1 indicando que o envio de dados terminou. Quando o envio de dados termina, ocorre uma mudança para o estado 11 onde aguarda até que o valor lógico do sinal accept seja 1, indicando a trama foi processada e accept seja 1, indicando a trama foi processada, ativando os sinais DXval e busy.

A descrição hardware do bloco Serial Receiver em VHDL encontra-se no Anexo A.

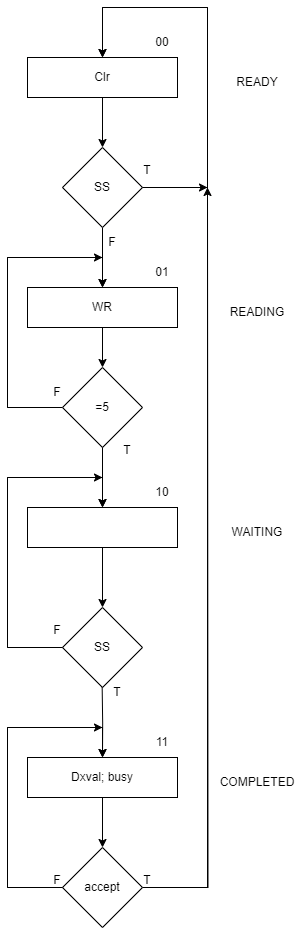
[picture p36: figure]

Figura 3 – Máquina de estados do bloco Serial Control

## 3 Door Controller

O bloco Door Controller, após este ter recebido uma trama válida recebida pelo Serial Receiver, deverá proceder à atuação do comando recebido no mecanismo da porta. Se o comando recebido for de abertura, o Door Controller deverá

# colocar o sinal OO ffffe o sinal OOOOOOOOCCCCCCCC no valor lógico

‘1’, até o sensor de porta aberta (FCopen) ficar ativo. No entanto, se o comando for de fecho, o Door Controller

deverá ativar o sinal OO

# ffff e colocar o sinal OOOOOOOO

# CCCCCCCC no

valor lógico ‘0’, até o sensor de porta fechada (FCclose) ficar ativo. Se durante o fecho for detetada uma pessoa na zonada porta, através do sensor de presença (Pdetect), o sistema deverá interromper o fecho reabrindo a porta. Após a interrupção do fecho da porta,o bloco Door Controller deverá permitir de forma automática, ou seja, sem necessidade de envio de uma nova trama, o encerramento da porta e o finalizar do comando de fecho .Após concluir qualquer um dos comandos, o Door Controller sinaliza o Serial Receiver que está pronto para processar uma nova trama através da ativação do sinal done.

O bloco Door Controller foi implementado pela máquina de estados representada em ASM-chart na Figura 4.

A descrição hardware do bloco Door Controller em VHDL encontra-se no Anexo B.

Inicialmente o bloco Door Controller encontra-se no estado 000, a aguardar que o nível lógico do sinal Dval seja “1” indicando uma trama válida. Quando recebe a indicação de uma trama válida, verifica o sinal OC de forma a apurar se o comando é para abrir ou fechar a porta. Se o comando é de é para abrir a porta, ocorre uma mudança para o estado

001, onde permanece com os sinais OO ffff (ativando o mecanismo da porta) e OOOOOOOO

# CCCCCCCC ativos até que esta esteja

completamente aberta , aguardando que o sinal Sopen tenha valor lógico “1”. De seguida verifica se a instrução é de fecho de forma a concluir a mesma, se a instrução é de abrir a porta, ocorre a passagem para o estado 100 em que o sinal done é ativado onde aguarda que o sinal Dval tenha valor lógico “0”. Se pelo contrário a instrução é de fechar a porta, a máquina de estados passa do estado 000 para o estado 010 onde verifica através do sinal Psensor se foi detetada alguma pessoa na zona da porta. Se não for detetada uma pessoa na zona da porta, passa para o estado 011 onde ativa o sinal OO ffff, de forma a ativar o mecanismo da porta e com

# o sinal OOOOOOOO

CCCCCCCC com valor lógico a “0” indicando que é

para fechar a porta, e permanece neste estado até que a porta esteja fechada, ativando o sinal Scloes. Se for detetada uma pessoa durante o fecho da porta ocorre uma passagem para o estado 001 de forma a abrir a porta. Depois de fechar a porta ocorre a passagem para o estado 100 ativando o sinal done informando que terminou de executar a instrução e aguarda que o sinal Dval tenha valor lógico “0”

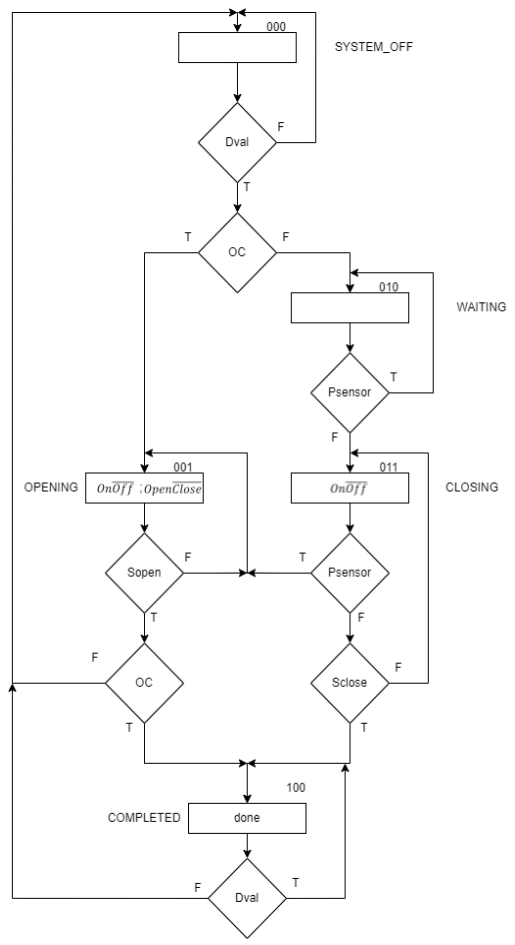
[picture p37: figure]

Figura 4 – Máquina de estados do bloco Door Controller

Com base nas descrições dos blocos Serial Receiver e Door Controller implementou-se o módulo Serial Door Controller de acordo com o esquema elétrico representado no Anexo C.

## 4 Interface com o Control

Implementou-se o módulo Control em software, recorrendo a linguagem Kotlin e seguindo a arquitetura lógica apresentada na Figura 8.

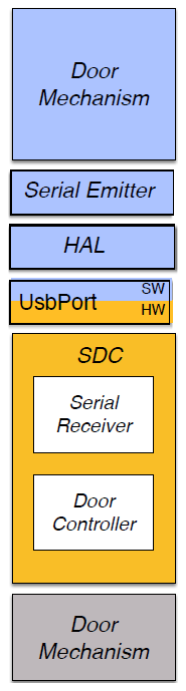
[picture p38: figure]

Figura 5 – Diagrama lógico do módulo Control de interface com o módulo Serial Door Controller

HAL, Serial Emitter e LCD desenvolvidos são descritos nas secções 4.1, 4.2 e 4.3, e o código fonte desenvolvido nos Anexos C e D, respetivamente.

## 4.1 HAL

A classe HAL é responsável por comunicar com o bloco UsbPort, fazendo a leitura e a escrita no bloco UsbPort. De forma a evitar efetuar a leitura do bloco UsbPort repetidamente foi criada uma variável global (written) dentro da classe para guardar o último valor escrito.
Nesta classe temos a função init que inicia a classe, a função isBit() que retorna true se o bit passado na máscara tiver o valor lógico 1. A função readBits() efetua uma leitura tal como a função isBit() mas para um conjunto de bits.
A função writeBits() escreve um valor num conjunto de bits, a função setBits() escreve nos bits da máscara o valor lógico
1. E a função clrBits() coloca o valor lógico 0 no bit indicado na máscara.

### 4.2 Serial Emitter

A classe Serial Emitter é responsável pelo envio de tramas para os diferentes módulos Serial Receiver.
De forma a distinguir os diferentes sinais necessários para a execução do módulo SLCDC, estes foram mapeados com o objetivo de serem obtidos e identificados no outputPort do módulo UsbPort.
A função send() implementada nesta fase é responsável por criar a situação de envio de uma trama para os módulos SLCDC e SDC.

## 4.3 Door Mechanism

A classe Door Mechanism é responsável por controlar o estado do mecanismo de fecho e de abertura da porta.
A função open() envia um comando para abrir a porta, com a velocidade passada com parâmetro.
A função close() envia um comando para fechar a porta, com a velocidade passada com parâmetro.
A função finished() verifica se o comando anterior está concluído.

## 5 Conclusões

O módulo SDC tem como objetivo entregar a informação que lhe chega por parte do Control em forma de uma trama de 5 bits ao Door Mechanism. Para isso, implementámos o Serial Receiver, responsável pela receção dos dados enviados pelo microcontrolador, e o bloco Door Controller que tem a função de entregar os dados recebidos ao Door Mechanism após a trama ser validada. O módulo Serial Receiver foi testado no simulador e posteriormente na placa, apresentando um funcionamento correto. O módulo Door Controller foi testado no simulador. O módulo SDC_USBPORT foi testado na placa onde apresentou um funcionamento correto.

## A. Descrição VHDL do bloco Serial Receiver Serial Control

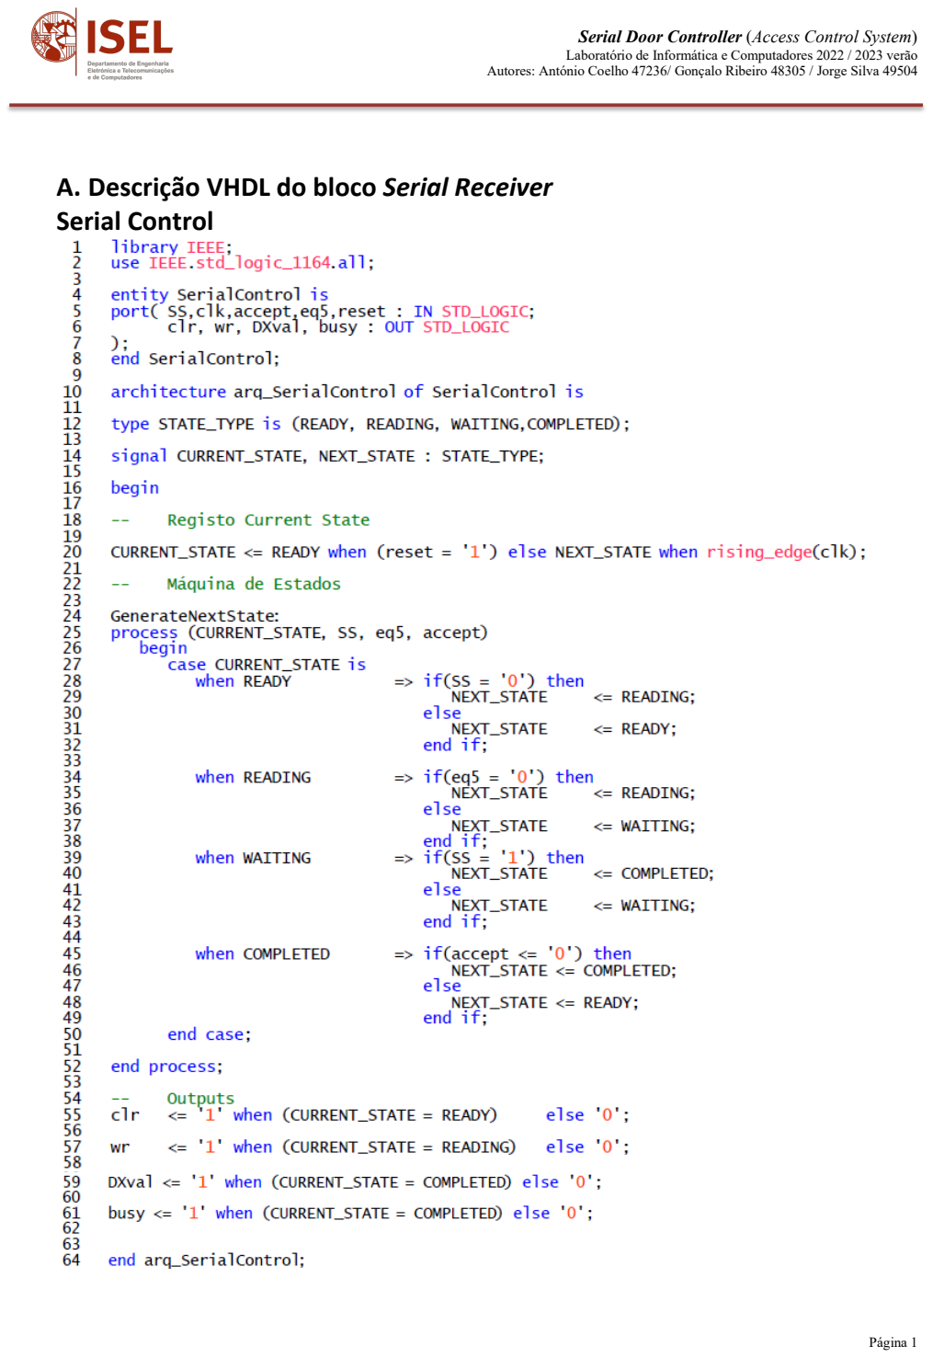
[picture p39: page 4]

## Counter

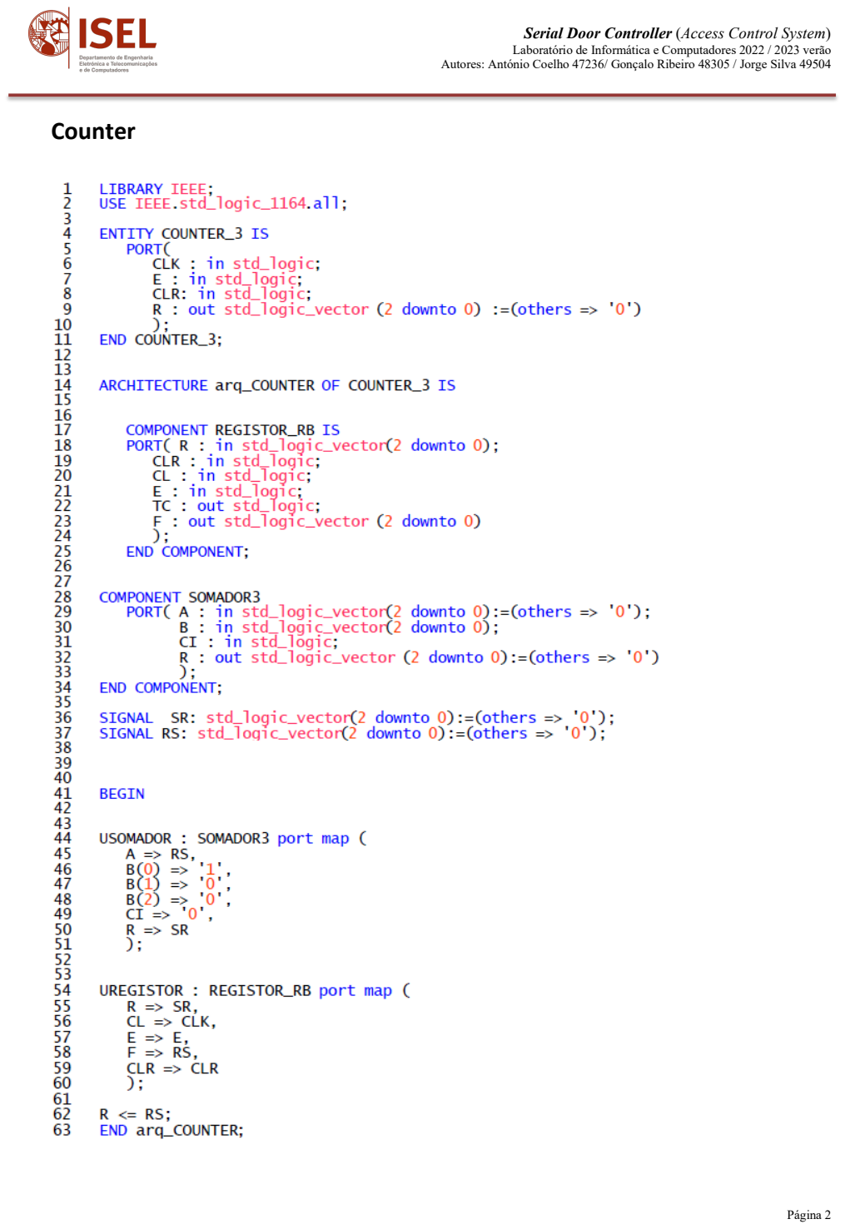
[picture p40: page 5]

## Shift Register

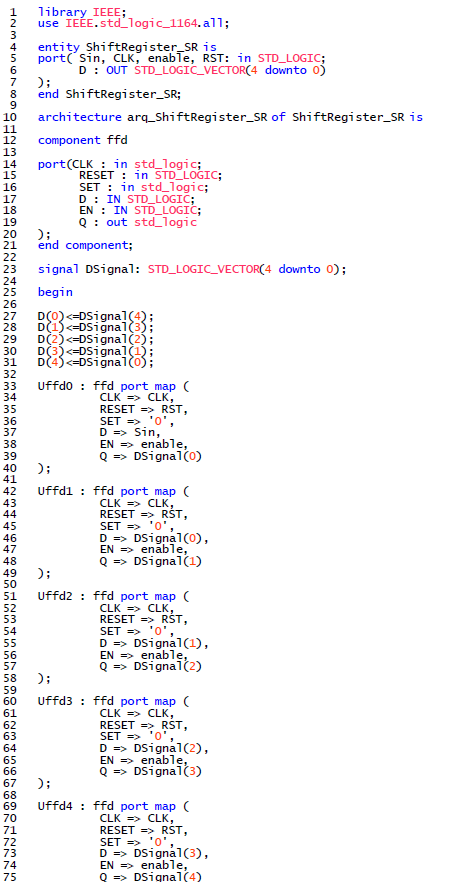
[picture p41: figure]

## Serial Receiver

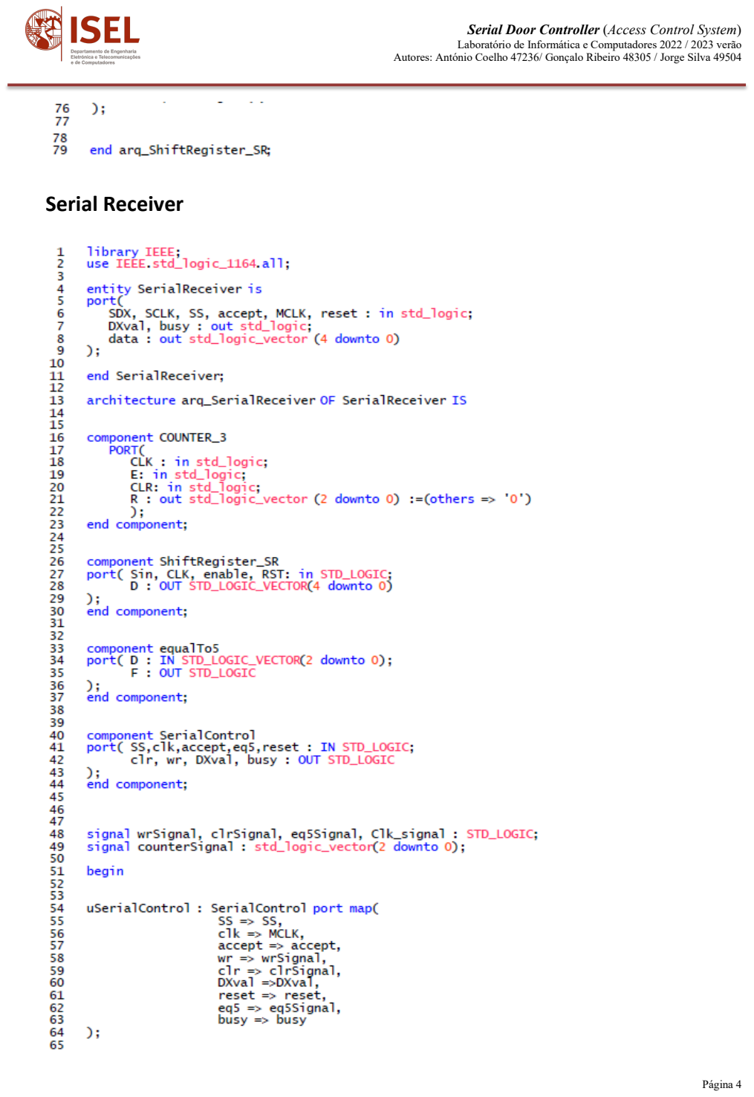
[picture p42: page 7]

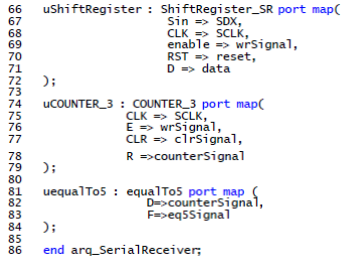
[picture p43: figure]

## B. Descrição VHDL do bloco Door Controller

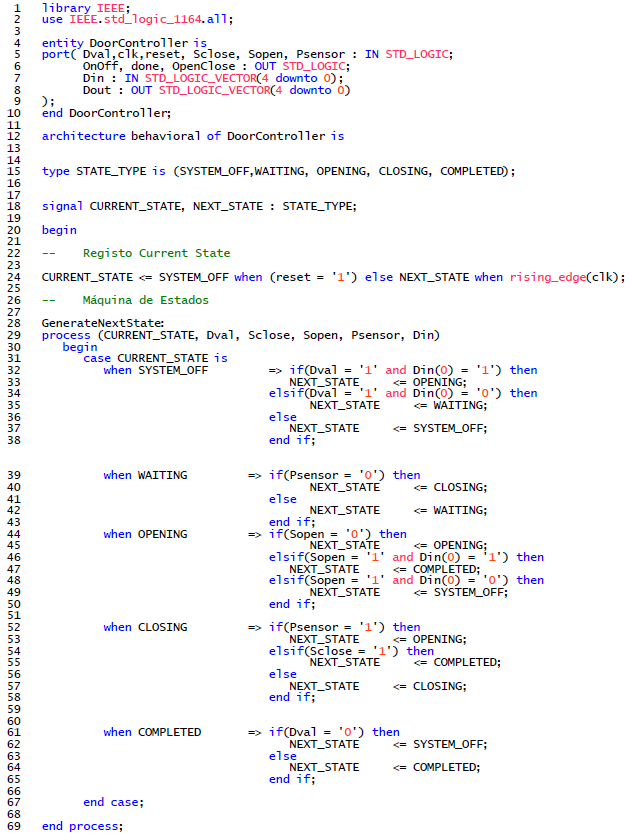
[picture p44: figure]

## C. Descrição VHDL do bloco SDC

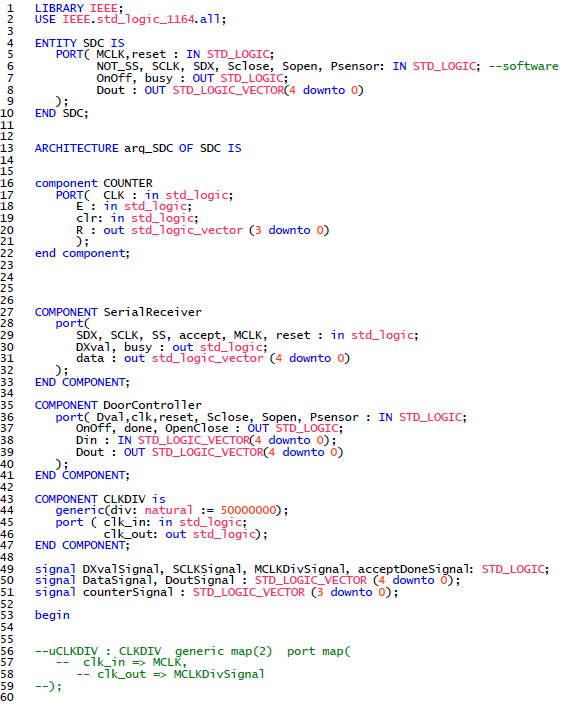
[picture p45: figure]

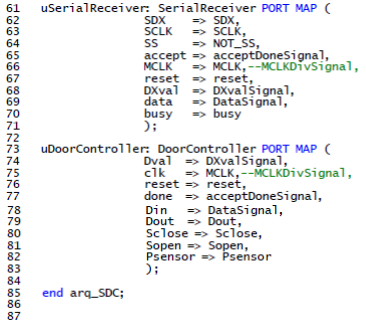
[picture p46: figure]

## D. Descrição VHDL do bloco SDC_USBPORT

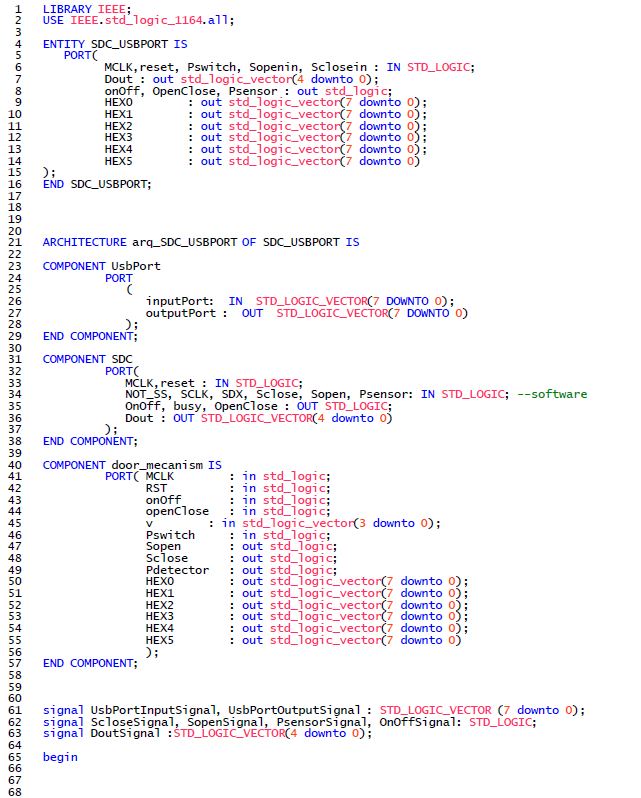
[picture p47: figure]

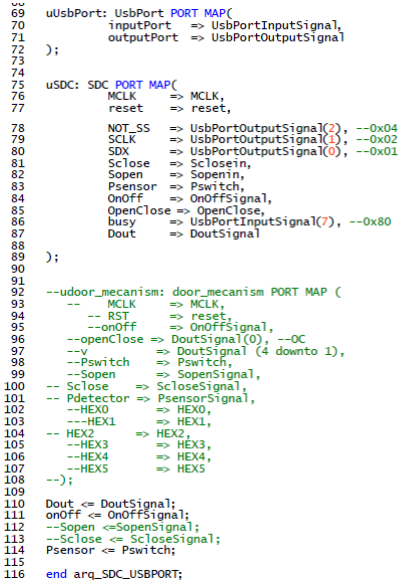
[picture p48: figure]

E. Atribuição de pinos do módulo SDC_USBPORT ==============================================================

# CLOCK

#============================================================ set_location_assignment PIN_P11 -to MCLK

#============================================================ # SW

#============================================================ set_location_assignment PIN_C10 -to reset

set_location_assignment PIN_C11 -to Pswitch
set_location_assignment PIN_D12 -to Sopenin
set_location_assignment PIN_C12 -to Sclosein

#LED

set_location_assignment PIN_A8 -to Dout[0] set_location_assignment PIN_A9 -to Dout[1] set_location_assignment PIN_A10 -to Dout[2] set_location_assignment PIN_B10 -to Dout[3] set_location_assignment PIN_D13 -to Dout[4] set_location_assignment PIN_C13 -to onOff #set_location_assignment PIN_E14 -to Sopen #set_location_assignment PIN_D14 -to Sclose set_location_assignment PIN_A11 -to Psensor
set_location_assignment PIN_B11 -to OpenClose

#============================================================ # HEX0

#============================================================ set_location_assignment PIN_C14 -to HEX0[0]

set_location_assignment PIN_E15 -to HEX0[1]
set_location_assignment PIN_C15 -to HEX0[2]
set_location_assignment PIN_C16 -to HEX0[3] set_location_assignment PIN_E16 -to HEX0[4] set_location_assignment PIN_D17 -to HEX0[5]
set_location_assignment PIN_C17 -to HEX0[6]
set_location_assignment PIN_D15 -to HEX0[7]

#============================================================ # HEX1

#============================================================ set_location_assignment PIN_C18 -to HEX1[0]

set_location_assignment PIN_D18 -to HEX1[1]
set_location_assignment PIN_E18 -to HEX1[2]
set_location_assignment PIN_B16 -to HEX1[3] set_location_assignment PIN_A17 -to HEX1[4] set_location_assignment PIN_A18 -to HEX1[5] set_location_assignment PIN_B17 -to HEX1[6]

set_location_assignment PIN_A16 -to HEX1[7]

#============================================================ # HEX2

#============================================================ set_location_assignment PIN_B20 -to HEX2[0]

set_location_assignment PIN_A20 -to HEX2[1]
set_location_assignment PIN_B19 -to HEX2[2]
set_location_assignment PIN_A21 -to HEX2[3] set_location_assignment PIN_B21 -to HEX2[4] set_location_assignment PIN_C22 -to HEX2[5]
set_location_assignment PIN_B22 -to HEX2[6]
set_location_assignment PIN_A19 -to HEX2[7] #============================================================ # HEX3
#============================================================ set_location_assignment PIN_F21 -to HEX3[0]

set_location_assignment PIN_E22 -to HEX3[1]
set_location_assignment PIN_E21 -to HEX3[2]
set_location_assignment PIN_C19 -to HEX3[3] set_location_assignment PIN_C20 -to HEX3[4] et_location_assignment PIN_D19 -to HEX3[5]
set_location_assignment PIN_E17 -to HEX3[6]
set_location_assignment PIN_D22 -to HEX3[7]

#============================================================ # HEX4

#============================================================ set_location_assignment PIN_F18 -to HEX4[0]

set_location_assignment PIN_E20 -to HEX4[1]
set_location_assignment PIN_E19 -to HEX4[2]
set_location_assignment PIN_J18 -to HEX4[3] set_location_assignment PIN_H19 -to HEX4[4] set_location_assignment PIN_F19 -to HEX4[5]
set_location_assignment PIN_F20 -to HEX4[6]
set_location_assignment PIN_F17 -to HEX4[7]

#============================================================ # HEX5

#============================================================ set_location_assignment PIN_J20 -to HEX5[0]

set_location_assignment PIN_K20 -to HEX5[1]
set_location_assignment PIN_L18 -to HEX5[2]
set_location_assignment PIN_N18 -to HEX5[3] set_location_assignment PIN_M20 -to HEX5[4] set_location_assignment PIN_N19 -to HEX5[5]
set_location_assignment PIN_N20 -to HEX5[6]
set_location_assignment PIN_L19 -to HEX5[7]

#============================================================ # End of pin and io_standard assignments #============================================================

## F. Código Kotlin - HAL

object HAL {
var written = 0b0000_0000
private var ACTIVE = false
fun init() { // Inicia a classe if(!ACTIVE) {
UsbPort.write(written)
ACTIVE=true
}
}

// Retorna true se o bit tiver o valor lógico ‘1’
fun isBit(mask: Int): Boolean = (mask and UsbPort.read()) != 0

// Retorna os valores dos bits representados por mask presentes no UsbPort fun readBits(mask: Int): Int = mask and UsbPort.read()

// Escreve nos bits representados por mask o valor de value
/**
* value -> 0000_1001.
* mask -> 0000_1111.
* lastWritten -> 1111_0111.
* new lastWritten -> 1111_1001.
* 1º: (value and mask) -> 0000_1001 sets the bits in value to be written to the ones in the mask.
* 2º: (lastWritten and mask.inv()) -> 1111_0000 sets the bits in lastWritten that are not in the mask,this operation
* sets to 0 all the bits in lastWritten that are not in the mask, preparing it to receive the updated value.
* 3º: (value and mask) or (lastWritten and mask.inv()) -> 0000_1001 or 1111_0000 -> 1111_1001 sets the bits in
* lastWritten that are in the mask to the corresponding bits in value and keeps the bits that are not in the mask unchanged.
*/

fun writeBits(mask: Int, value: Int) {
| written = (value and mask) or (written and mask.inv()) UsbPort.write(written)

}

// Coloca os bits representados por mask no valor lógico ‘1’ fun setBits(mask: Int) {
| written = (written or mask) UsbPort.write(written)

}

// Coloca os bits representados por mask no valor lógico ‘0’ fun clrBits(mask: Int) {
| written = written and mask.inv() UsbPort.write(written)

}

}

## G. Código Kotlin – Serial Emitter

/**
* Mapeamento
* | n | 7 | 6 | 5 | 4 | 3 | 2 | 1 | 0
* inputPort :BSY | 0 | 0 | 0 | 0 | 0 | 0 | 0 | //inputPort(n)
* outPort | : 0 | 0 | 0 | 0 LCD DOOR SCLK SDX //outputPort(n)
* | | | | | | SS | SS
* D[0:4] : | - - | - D(3) D(2) D(1) D(0) RS
**/

object SerialEmitter { // Envia tramas para os diferentes módulos Serial Receiver enum class Destination {LCD, DOOR}
private const val MASK_BUSY = 0x80
private const val MASK_NOT_SS_LCD = 0x08
private const val MASK_NOT_SS_DOOR = 0x04 private const val MASK_SCLK = 0x02 private const val MASK_SDX = 0x01 private const val DATA_SIZE = 5

// Inicia a classe
fun init() {
HAL.init()
HAL.setBits(MASK_NOT_SS_LCD) // SS = 1 HAL.setBits(MASK_NOT_SS_DOOR) // SS = 1
HAL.clrBits(MASK_SCLK) | // SCLK = 0
HAL.clrBits(MASK_SDX) | // SDX = 0
}

// Envia uma trama para o SerialReceiver identificado o destino em addr e os bits de dados em‘data’.
fun send(addr: Destination, value: Int) {
var data = value
while (isBusy()) { }
val address = if (addr == Destination.LCD) MASK_NOT_SS_LCD else MASK_NOT_SS_DOOR for (i in 0 until DATA_SIZE) {
HAL.clrBits(MASK_SCLK) | // SCLK = 0
HAL.clrBits(address) | // SS = 0
HAL.writeBits(0x01, 0x01 and data) | // SDX = data[0]
data = data shr 1 | // data = data >> 1 to send bit a bit
HAL.setBits(MASK_SCLK) | // SCLK = 1
}
HAL.clrBits(0x01) | // SDX = 0
HAL.clrBits(MASK_SCLK) | // SCLK = 0
HAL.setBits(address) | // SS = 1

}

// Retorna true se o canal série estiver ocupado
fun isBusy(): Boolean = HAL.isBit(MASK_BUSY)

}

## H. Código Kotlin – Door Mechanism

/*
* Enviar pelo SerialEmmiter tal como no LCD
* Dados: | D4 D3 D2 D1 D0
* | V3 V2 V1 V0 OC
*
* OC -> 0 Fechar | 1 Abrir
* V3..0 -> Velocidade
* */

object DoorMechanism { // Controla o estado do mecanismo de abertura da porta.

// Inicia a classe, estabelecendoos valores iniciais.
fun init() {
SerialEmitter.init()
}
// Envia comando para abrir a porta, com o parâmetro de velocidade
fun open(velocity: Int) {
SerialEmitter.send(SerialEmitter.Destination.DOOR, (velocity shl 1) or 1)
//D4..1 -> Velocidade | D0 -> OC -> 1 Abrir
}
// Envia comando para fechar a porta, com o parâmetro de velocidade
fun close(velocity: Int) { SerialEmitter.send(SerialEmitter.Destination.DOOR, (velocity shl 1 )or 0)
//D4..1 -> Velocidade | D0 -> OC -> 0 Fechar
}
// Verifica se o comando anterior está concluído
fun finished(): Boolean = !SerialEmitter.isBusy() }
