GoncaloRibeiro6533/Access-Control-System/docs/moduloSerialLCDController_LEIC21D_G06.pdf

Serial LCD Controller (Access Control System)
Laboratório de Informática e Computadores 2022 / 2023 verão Autores: António Coelho 47236/ Gonçalo Ribeiro 48305 / Jorge Silva 49504

O bloco Serial Receiver do SLCDC é constituído por três blocos principais: i) um bloco de controlo; ii) um contador de bit srecebidos; e iii) um bloco conversor série paralelo, designados respetivamente por Serial Control, Counter, e
Shift | Register

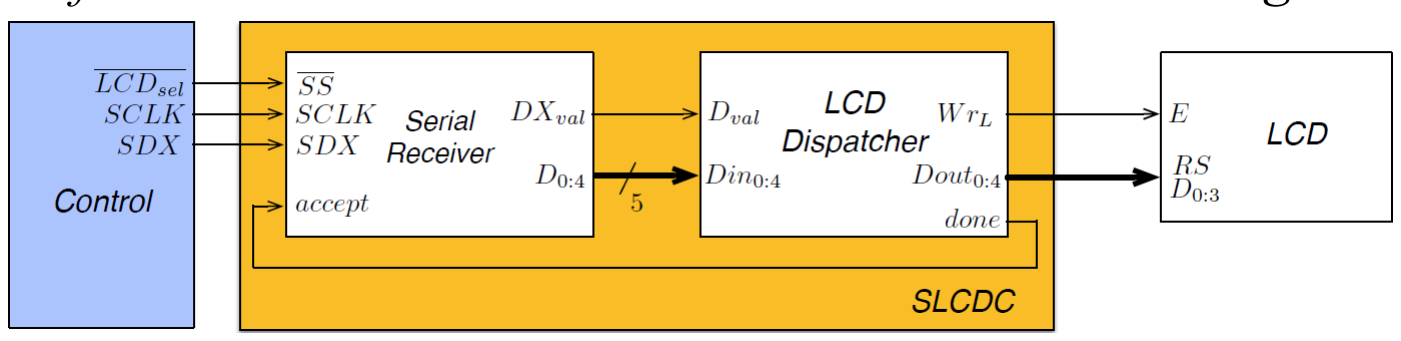
[picture p49: figure]

Figura 1 – Diagrama de blocos do módulo Serial LCD Controller

## 1 Serial Receiver


Figura 2 – Diagrama de Blocos do bloco Serial Receiver O bloco Serial Receiver é utilizado tanto no módulo Serial LCD Controller como no módulo Serial Door Controller, desta forma foi possível reutilizar o bloco Serial Receiver nos dois módulos.

O bloco Serial Control foi implementado pela máquina de estados representada em ASM-chart na Figura 3.

Inicialmente o Serial Control encontra-se estado 00 o sinal Clr está ativo de forma que o counter permaneça inativo até que o valor lógico do sinal SS seja 0 indicando que o envio de dados irá começar. Enquanto permanece no estado 01 o sinal WR fica ativo e permanece ativo até que sejam contados 5 bits na transferência de dados. Quando o número de bits recebidos atinge o valor 5 ocorre uma passagem para o estado 10, e permanece neste até que o sinal SS esteja com o valor lógico 1 indicando que o envio de dados terminou. Quando o envio de dados termina, ocorre uma mudança para o estado 11 onde aguarda até que o valor lógico do sinal accept seja 1, indicando a trama foi processada.

A descrição hardware do bloco Serial Receiver em VHDL encontra-se no Anexo A.


Figura 3 – Máquina de estados do bloco Serial Control

## 3 Dispatcher

O bloco Dispatcher entrega a trama recebida pelo Serial Receiver ao LCD através da ativação do sinal WrL, após este ter recebido uma trama válida, indicado pela ativação do sinal DXval.
O LCD processa as tramas recebidas de acordo com os comandos definidos pelo fabricante, não sendo necessário esperar pela sua execução para libertar o canal de receção série. Assim, o Dispatcher pode sinalizar ao Serial Receiver que a trama foi processada, ativando o sinal done.

O bloco Dispatcher foi implementado pela máquina de estados representada em ASM-chart na Figura 4.

A descrição hardware do bloco Dispatcher em VHDL encontra-se no Anexo B.

Inicialmente o bloco Dispatcher encontra-se no estado 00, a aguardar que o valor lógico do sinal Dval seja 1 indicando uma trama válida. Quando recebe a indicação de uma trama válida, ocorre uma mudança para o estado 01, onde permanece com o sinal WRL ativo (ativando o Enable do LCD) até que sejam atingidos 12 ciclos de relógio de forma a escrever no LCD (mínimo 230 ns).
Ao atingir os 12 ciclos de relógio ocorre a passagem para o estado 10 onde o sinal done é ativado e mantem-se no estado 10 até que valor lógico do sinal Dval esteja desativado de modo a evitar múltiplas escritas, quando o sinal Dval estiver desativado regressa ao estado 00.

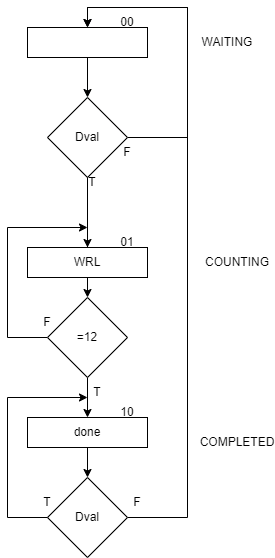
[picture p50: figure]

Figura 4 – Máquina de estados do bloco Dispatcher

Com base nas descrições dos blocos Serial Receiver e Dispatcher implementou-se o módulo Serial LCD Controller de acordo com o esquema elétrico representado no Anexo C.

## 4 Interface com o Control

Implementou-se o módulo Control em software, recorrendo a linguagem Kotlin e seguindo a arquitetura lógica apresentada na Figura 8.

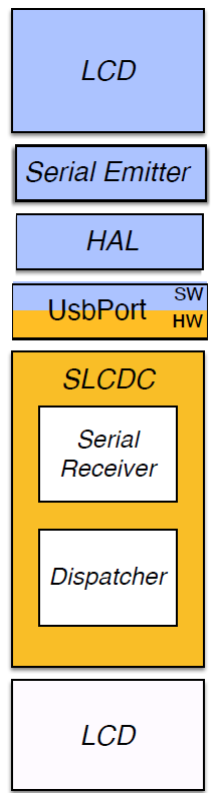
[picture p51: figure]

Figura 5 – Diagrama lógico do módulo Control de interface com o módulo Serial LCD Controller

HAL, Serial Emitter e LCD desenvolvidos são descritos nas secções 4.1, 4.2 e 4.3, e o código fonte desenvolvido nos Anexos C e D, respetivamente.

## 4.1 HAL

A classe HAL é responsável por comunicar com o bloco UsbPort, fazendo a leitura e a escrita no bloco UsbPort. De forma a evitar efetuar a leitura do bloco UsbPort repetidamente foi criada uma variável global (written) dentro da classe para guardar o último valor escrito.
Nesta classe temos a função init que inicia a classe, a função isBit() que retorna true se o bit passado na máscara tiver o valor lógico 1. A função readBits() efetua uma leitura tal como a função isBit() mas para um conjunto de bits.
A função writeBits() escreve um valor num conjunto de bits, a função setBits() escreve nos bits da máscara o valor lógico
1. E a função clrBits() coloca o valor lógico 0 no bit indicado na máscara.

### 4.2 Serial Emitter

A classe Serial Emitter é responsável pelo envio de tramas para os diferentes módulos Serial Receiver.
De forma a distinguir os diferentes sinais necessários para a execução do módulo SLCDC, estes foram mapeados com o objetivo de serem obtidos e identificados no outputPort do módulo UsbPort.
A função send() implementada nesta fase é responsável por criar a situação de envio de uma trama para os módulos SLCDC e SDC.

## 4.3 LCD

A classe LCD é responsável por escrever no LCD usando a interface a 4 bits.
A função writeNibbleParalel() escreve um nibble de comando ou dados no LCD em paralelo.
Afunção writeNibbleSerial() recorre à função send() do SerialEmitter para escrever um nibble de comando ou dados no LCD em série.
A função writeNibble() escreve um nibble de comandos ou dados no LCD.
A função writeByte() escreve um byte de comandos ou dados no LCD.
A função writeCMD() escreve um comando no LCD.
A função writeDATA() escreve dados no LCD.
A função write(c:Char) escreve um caracter na posição corrente
A função write(c:String) escreve uma string na posição corrente.
A finção cursor() posiciona o cursor na posição desejada. A função clear() limpa o ecrã e coloca o cursor em (0,0).

## 5 Conclusões

O módulo SLCDC tem como objetivo entregar a informação que lhe chega por parte do Control em forma de uma trama de 5 bits ao LCD. Para isso, implementámos o módulo Serial Receiver, responsável pela receção dos dados enviados pelo microcontrolador, e o bloco Dispatcher que tem a função de entregar os dados recebidos ao LCD após a trama ser validada. O módulo Serial Receiver foi testado no simulador e posteriormente na placa, apresentando um funcionamento correto. O módulo Dispatcher foi testado no simulador e mais tarde foi testado na placa, no módulo SLCDC_USBPORT, juntamente com o software, onde também observámos o correto funcionamento deste módulo.

## A. Descrição VHDL do bloco Serial Receiver Serial Control

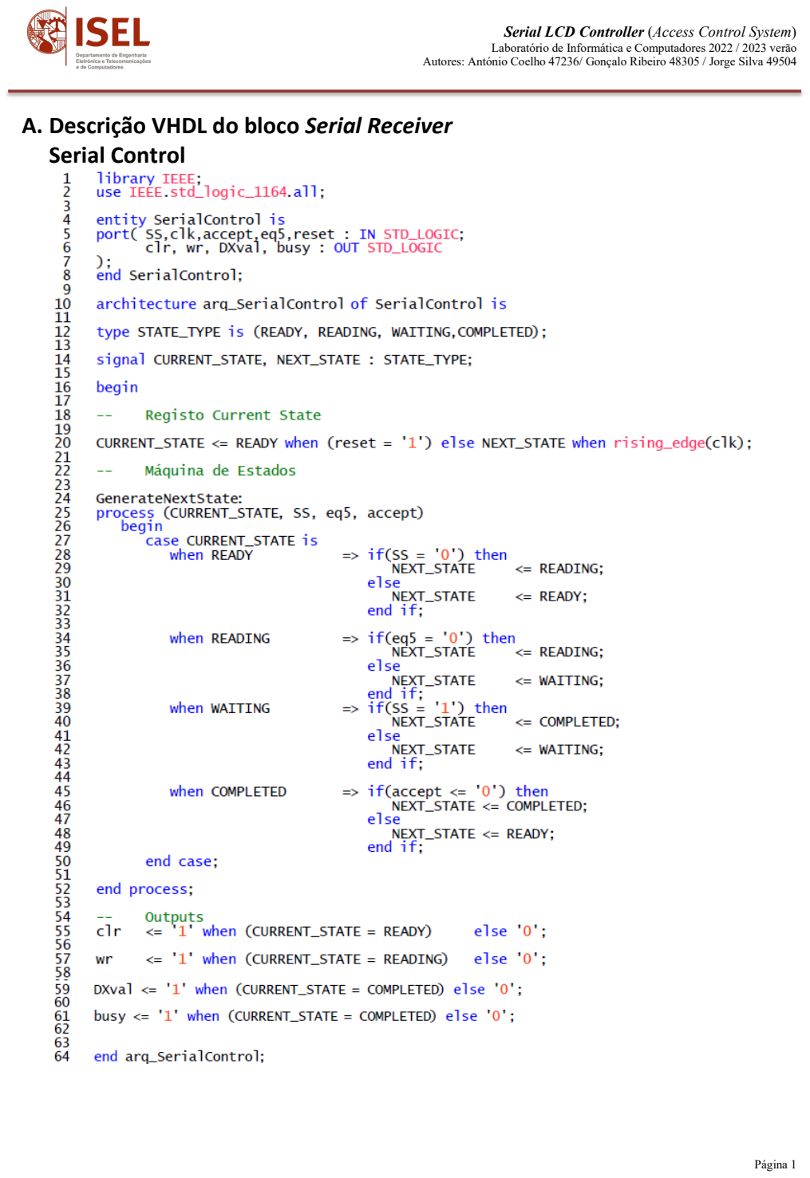
[picture p52: page 4]

## Counter

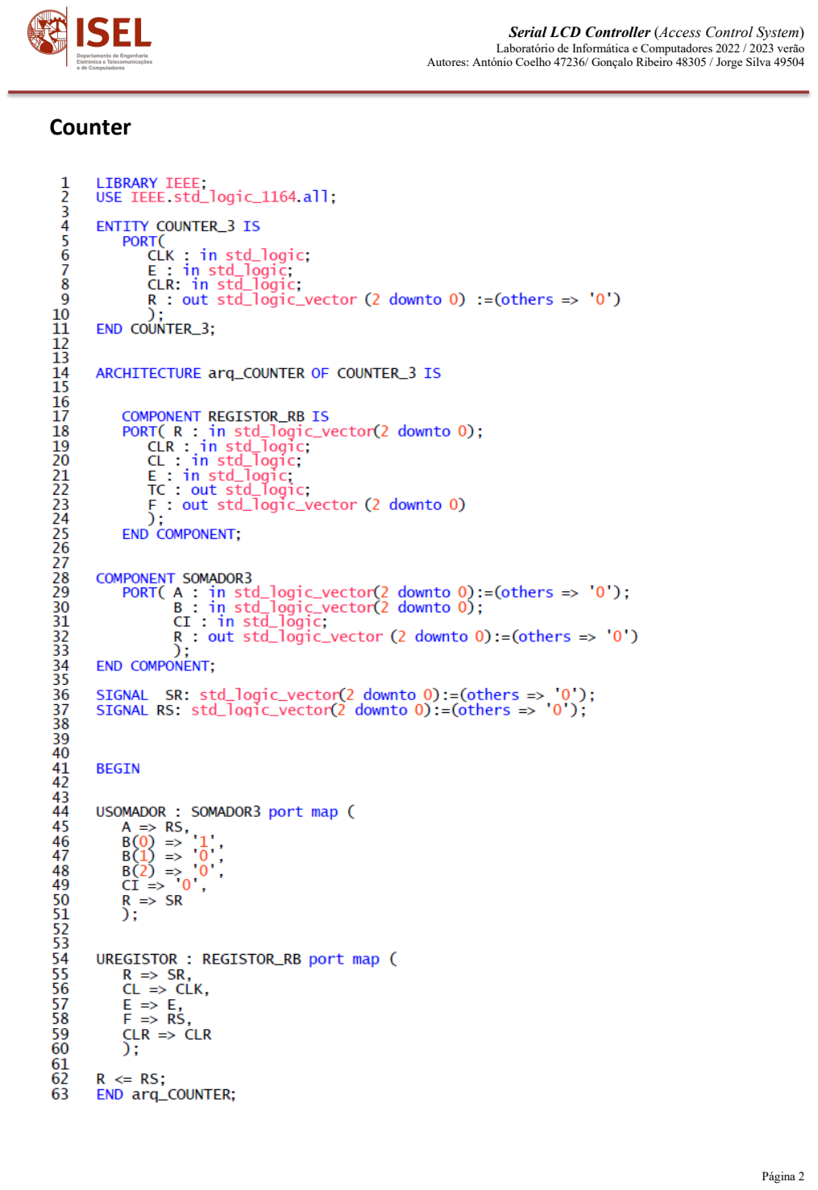
[picture p53: page 5]

## Shift Register


## Serial Receiver

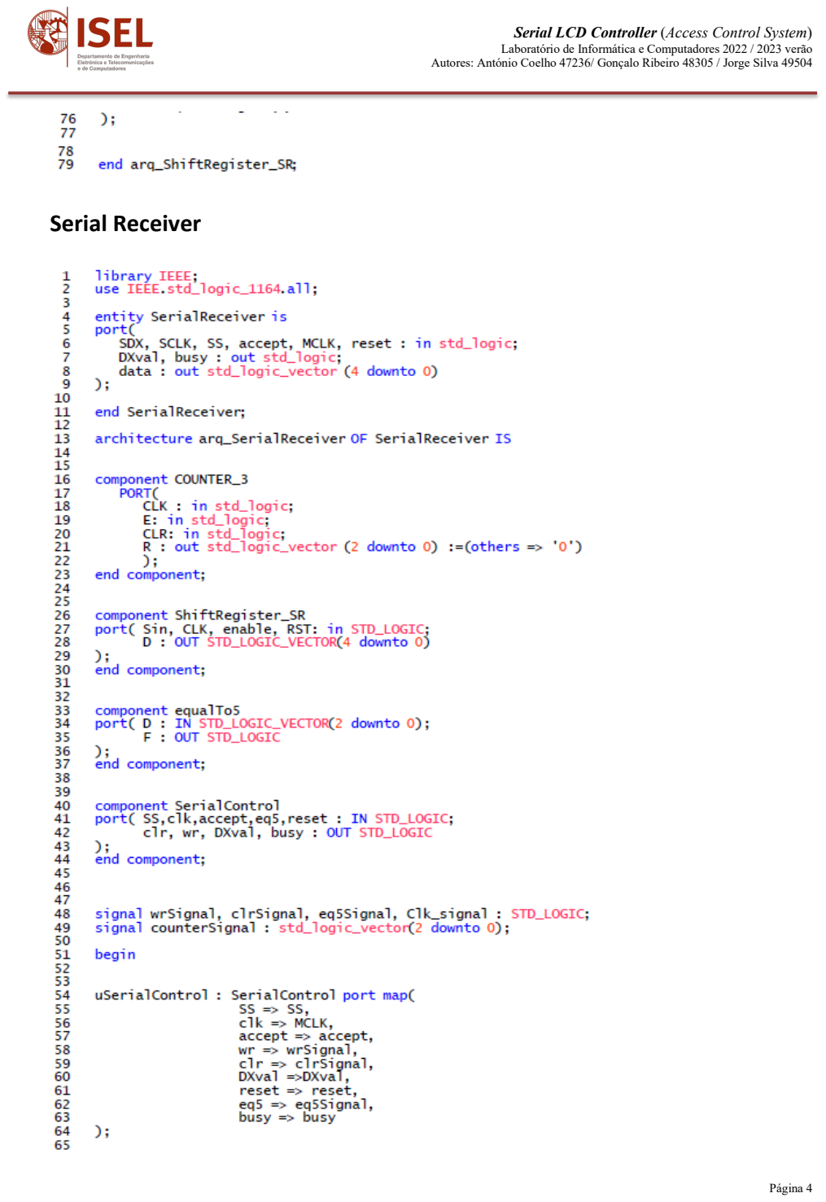
[picture p54: page 7]


## B. Descrição VHDL do bloco Dispatcher

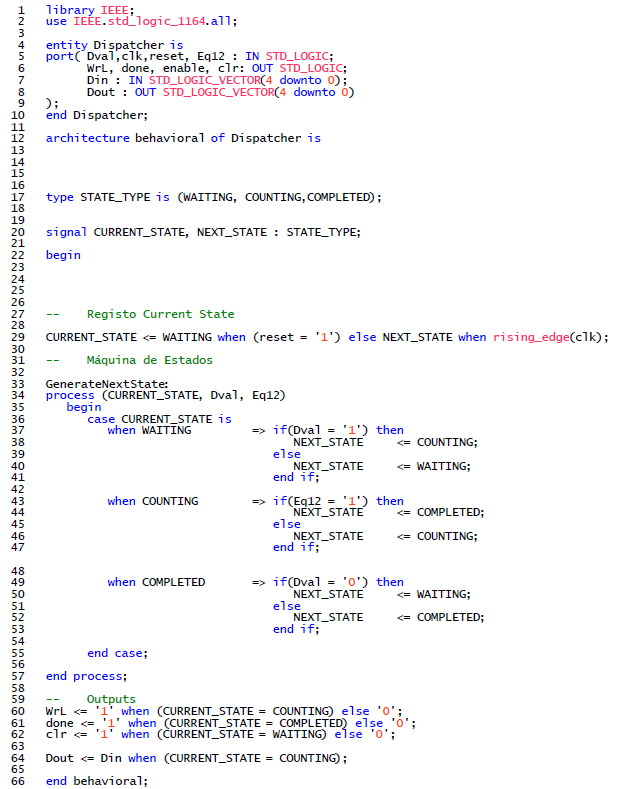
[picture p55: figure]

## C. Descrição VHDL do bloco SLCDC

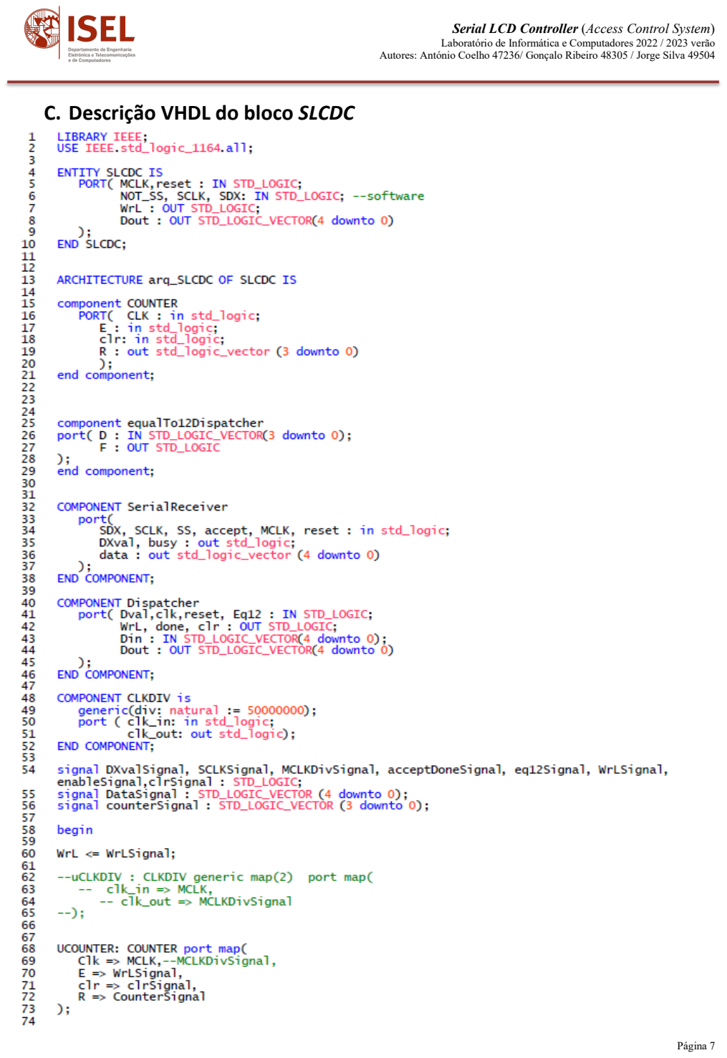
[picture p56: page 10]

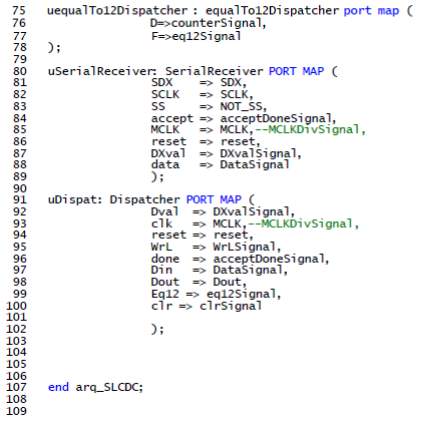
[picture p57: figure]

## D. Descrição VHDL do bloco SLCDC_USBPORT

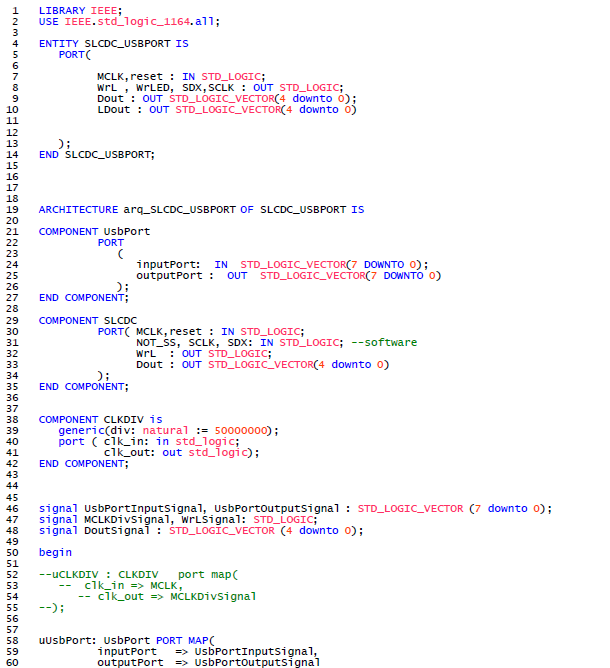
[picture p58: figure]

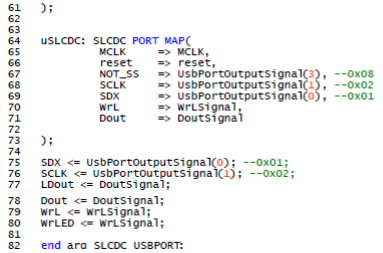
[picture p59: figure]

## E. Atribuição de pinos do módulo SLDC_USBPORT

#============================================================ # CLOCK

#============================================================

set_location_assignment PIN_P11 -to MCLK

#============================================================ # SW

#============================================================ set_location_assignment PIN_C10 -to reset

#========================================================== #LCD

#========================================================== set_location_assignment PIN_W8 -to Dout[0]

set_location_assignment PIN_V5 -to WrL

set_location_assignment PIN_W11 -to Dout[1]
set_location_assignment PIN_AA10 -to Dout[2]
set_location_assignment PIN_Y8 -to Dout[3]
set_location_assignment PIN_Y7 -to Dout[4]

#============================================================ # LED

#============================================================ set_location_assignment PIN_A8 -to LDout[0]

set_location_assignment PIN_A9 -to WrLED
set_location_assignment PIN_A10 -to LDout[1]
set_location_assignment PIN_B10 -to LDout[2] set_location_assignment PIN_D13 -to LDout[3] set_location_assignment PIN_C13 -to LDout[4] #set_location_assignment PIN_E14 -to LEDR[6] #set_location_assignment PIN_D14 -to LEDR[7] set_location_assignment PIN_A11 -to SDX
set_location_assignment PIN_B11 -to SCLK

#============================================================ # End of pin and io_standard assignments #============================================================

## F. Código Kotlin - HAL

object HAL {
var written = 0b0000_0000
private var ACTIVE = false
fun init() { // Inicia a classe if(!ACTIVE) {
UsbPort.write(written)
ACTIVE=true
}
}

// Retorna true se o bit tiver o valor lógico ‘1’
fun isBit(mask: Int): Boolean = (mask and UsbPort.read()) != 0

// Retorna os valores dos bits representados por mask presentes no UsbPort fun readBits(mask: Int): Int = mask and UsbPort.read()

// Escreve nos bits representados por mask o valor de value
/**
* value -> 0000_1001.
* mask -> 0000_1111.
* lastWritten -> 1111_0111.
* new lastWritten -> 1111_1001.
* 1º: (value and mask) -> 0000_1001 sets the bits in value to be written to the ones in the mask.
* 2º: (lastWritten and mask.inv()) -> 1111_0000 sets the bits in lastWritten that are not in the mask,this operation
* sets to 0 all the bits in lastWritten that are not in the mask, preparing it to receive the updated value.
* 3º: (value and mask) or (lastWritten and mask.inv()) -> 0000_1001 or 1111_0000 -> 1111_1001 sets the bits in
* lastWritten that are in the mask to the corresponding bits in value and keeps the bits that are not in the mask unchanged.
*/

fun writeBits(mask: Int, value: Int) {
| written = (value and mask) or (written and mask.inv()) UsbPort.write(written)

}

// Coloca os bits representados por mask no valor lógico ‘1’ fun setBits(mask: Int) {
| written = (written or mask) UsbPort.write(written)

}

// Coloca os bits representados por mask no valor lógico ‘0’ fun clrBits(mask: Int) {
| written = written and mask.inv() UsbPort.write(written)

}

}

## G. Código Kotlin – Serial Emitter

/**
* Mapeamento
* | n | 7 | 6 | 5 | 4 | 3 | 2 | 1 | 0
* inputPort :BSY | 0 | 0 | 0 | 0 | 0 | 0 | 0 | //inputPort(n)
* outPort | : 0 | 0 | 0 | 0 LCD DOOR SCLK SDX //outputPort(n)
* | | | | | | SS | SS
* D[0:4] : | - - | - D(3) D(2) D(1) D(0) RS
**/

object SerialEmitter { // Envia tramas para os diferentes módulos Serial Receiver enum class Destination {LCD, DOOR}
private const val MASK_BUSY = 0x80
private const val MASK_NOT_SS_LCD = 0x08
private const val MASK_NOT_SS_DOOR = 0x04 private const val MASK_SCLK = 0x02 private const val MASK_SDX = 0x01 private const val DATA_SIZE = 5

// Inicia a classe
fun init() {
HAL.init()
HAL.setBits(MASK_NOT_SS_LCD) // SS = 1 HAL.setBits(MASK_NOT_SS_DOOR) // SS = 1
HAL.clrBits(MASK_SCLK) | // SCLK = 0
HAL.clrBits(MASK_SDX) | // SDX = 0
}

// Envia uma trama para o SerialReceiver identificado o destino em addr e os bits de dados em‘data’.
fun send(addr: Destination, value: Int) {
var data = value
while (isBusy()) { }
val address = if (addr == Destination.LCD) MASK_NOT_SS_LCD else MASK_NOT_SS_DOOR for (i in 0 until DATA_SIZE) {
HAL.clrBits(MASK_SCLK) | // SCLK = 0
HAL.clrBits(address) | // SS = 0
HAL.writeBits(0x01, 0x01 and data) | // SDX = data[0]
data = data shr 1 | // data = data >> 1 to send bit a bit
HAL.setBits(MASK_SCLK) | // SCLK = 1
}
HAL.clrBits(0x01) | // SDX = 0
HAL.clrBits(MASK_SCLK) | // SCLK = 0
HAL.setBits(address) | // SS = 1

}

// Retorna true se o canal série estiver ocupado
fun isBusy(): Boolean = HAL.isBit(MASK_BUSY)

}

## H. Código Kotlin – LCD

/**
* LCD 16*2
* Display positions
*
* 1º line: 0x00 to 0x0F
* 2º line: 0x40 to 0x4F
*
* DDRAM : Display data RAM
* CGRAM : Character generator RAM
* ACG | : CGRAM address
* ADD | : DDRAM address (cursor address)
* AC | : address counter used for DD and CGRAM addresses
* DDRAM 0 0 1 ADD ADD ADD ADD ADD ADD
*
*/
object LCD {
// Escreve no LCD usando a interface a 4bits
private const val LINES = 2
const val COLS = 16 // Dimensão do display.
private const val DISPLAY_ON = 0xF //Mascara para ligar o display, private const val DISPLAY_OFF = 0x8 //Mascara para desligar o display private const val DISPLAY_SET = 0x3 //Function set
private const val MASK_ENTRYMODE = 0x6 //Mascara para entry mode
private const val DISPLAY_SET_NIBBLE = 0x2 //set 4 bits
private const val MASK_PARALLEL_RS = 0x10 //Mascara para o bit de RS
private const val MASK_LOW_DATA = 0x0F //Mascara para os 4 bits menos significativos
private const val MASK_HIGH_DATA = 0xF0 //Mascara para os 4 bits mais significativos
private const val DISPLAY_CLEAR : Int = 0x1 //Mascara para instrução de limpar o display private const val DISPLAY_CONFIG :Int=0x28//Mascara para configurar as linhas e a fonte do LCD

// Escreve um nibble de comando/dados no LCD em paralelo
//data -> d3..d0, recebe os quatro bits de menor peso
private fun writeNibbleParallel(rs: Boolean, data: Int){
| if (rs) {
| HAL.setBits(MASK_PARALLEL_RS) //RS = 1
| } else {
| HAL.clrBits(MASK_PARALLEL_RS)//RS = 0
| }
| HAL.writeBits(MASK_LOW_DATA, data) //d3..d0
}

// Escreve um nibble de comando/dados no LCD em série
private fun writeNibbleSerial(rs: Boolean, data: Int) {
| var d = data
| if (rs) d = (data shl 1) or 0x01 else d = (d shl 1) or 0x00
| SerialEmitter.send(SerialEmitter.Destination.LCD, d)
}

// Escreve um nibble de comando/dados no LCD
private fun writeNibble(rs: Boolean, data: Int) {
| writeNibbleSerial(rs,data)

}

// Escreve um byte de comando/dados no LCD
private fun writeByte(rs: Boolean, data: Int) { writeNibble(rs, (MASK_HIGH_DATA and data) shr 4) writeNibble(rs, MASK_LOW_DATA and data)
}

// Escreve um comando no LCD
private fun writeCMD(data: Int) { writeByte(false, data)

}
// Escreve um dado no LCD
private fun writeDATA(data: Int) { writeByte(true, data)

}

// Envia a sequência de iniciação para comunicação a 4 bits. fun init() {
SerialEmitter.init()
Time.sleep(15)
writeNibble(false, DISPLAY_SET) Time.sleep(5)
writeNibble(false, DISPLAY_SET) Time.sleep(1)
writeNibble(false, DISPLAY_SET) writeNibble(false, DISPLAY_SET_NIBBLE)
// Function Set, interface a 4 bits writeCMD(DISPLAY_CONFIG) // define N:1, F:0 writeCMD(DISPLAY_OFF) // display off writeCMD(DISPLAY_CLEAR) // clear writeCMD(MASK_ENTRYMODE) // define I/D:1, S:0 writeCMD(DISPLAY_ON) // display on
}

// Escreve um caracter na posição corrente.
fun write(c: Char) =
writeDATA(c.code)

// Escreve uma string na posição corrente. fun write(text: String) {
for (c in text) {
write(c)
}

}

// Envia comando para posicionar cursor (‘line’:0..LINES-1 , ‘column’:0..COLS-1) fun cursor(line: Int, column: Int) ...
fun cursor(line: Int, column: Int): Unit {
if (line >= LINES || line < 0 || column >= COLS || column < 0) return writeCMD((line * 0x40 + column) or 0x80)
}

// Envia comando para limpar o ecrã e posicionar o cursor em (0,0) fun clear() {
writeCMD(DISPLAY_CLEAR)
cursor(0,0)
}

}
