GoncaloRibeiro6533/Access-Control-System/hardware/Project/db/project.smp_dump.txt

State Machine - |AccessControlSystem|SDC:uSDC|DoorController:uDoorController|CURRENT_STATE
Name CURRENT_STATE.COMPLETED CURRENT_STATE.CLOSING CURRENT_STATE.OPENING CURRENT_STATE.WAITING CURRENT_STATE.SYSTEM_OFF 
CURRENT_STATE.SYSTEM_OFF 0 0 0 0 0 
CURRENT_STATE.WAITING 0 0 0 1 1 
CURRENT_STATE.OPENING 0 0 1 0 1 
CURRENT_STATE.CLOSING 0 1 0 0 1 
CURRENT_STATE.COMPLETED 1 0 0 0 1 

State Machine - |AccessControlSystem|SDC:uSDC|SerialReceiver:uSerialReceiver|SerialControl:uSerialControl|CURRENT_STATE
Name CURRENT_STATE.COMPLETED CURRENT_STATE.WAITING CURRENT_STATE.READING CURRENT_STATE.READY 
CURRENT_STATE.READY 0 0 0 0 
CURRENT_STATE.READING 0 0 1 1 
CURRENT_STATE.WAITING 0 1 0 1 
CURRENT_STATE.COMPLETED 1 0 0 1 

State Machine - |AccessControlSystem|SLCDC:uSLCDC|Dispatcher:uDispat|CURRENT_STATE
Name CURRENT_STATE.COMPLETED CURRENT_STATE.COUNTING CURRENT_STATE.WAITING 
CURRENT_STATE.WAITING 0 0 0 
CURRENT_STATE.COUNTING 0 1 1 
CURRENT_STATE.COMPLETED 1 0 1 

State Machine - |AccessControlSystem|SLCDC:uSLCDC|SerialReceiver:uSerialReceiver|SerialControl:uSerialControl|CURRENT_STATE
Name CURRENT_STATE.COMPLETED CURRENT_STATE.WAITING CURRENT_STATE.READING CURRENT_STATE.READY 
CURRENT_STATE.READY 0 0 0 0 
CURRENT_STATE.READING 0 0 1 1 
CURRENT_STATE.WAITING 0 1 0 1 
CURRENT_STATE.COMPLETED 1 0 0 1 

State Machine - |AccessControlSystem|Keyboard_Reader:uKeyboard_Reader|Key_Decode:uKey_Decode|KEY_CONTROL:uKeyControL|CurrentState
Name CurrentState.STATE_WRITING_COMPLETE CurrentState.STATE_WRITING CurrentState.STATE_NOT_WRITING 
CurrentState.STATE_NOT_WRITING 0 0 0 
CurrentState.STATE_WRITING 0 1 1 
CurrentState.STATE_WRITING_COMPLETE 1 0 1 

State Machine - |AccessControlSystem|Keyboard_Reader:uKeyboard_Reader|Output_Buffer:uOutput_Buffer|OutputBufferControl:UOutputBufferControl|CURRENT_STATE
Name CURRENT_STATE.ACKN CURRENT_STATE.COMPLETED CURRENT_STATE.SENDING CURRENT_STATE.WAITING 
CURRENT_STATE.WAITING 0 0 0 0 
CURRENT_STATE.SENDING 0 0 1 1 
CURRENT_STATE.COMPLETED 0 1 0 1 
CURRENT_STATE.ACKN 1 0 0 1 

State Machine - |AccessControlSystem|Keyboard_Reader:uKeyboard_Reader|Ring_Buffer:uRing_Buffer|RingBufferControl:URingBufferControl|CURRENT_STATE
Name CURRENT_STATE.COMPLETED CURRENT_STATE.INCRGET CURRENT_STATE.INCRPUT CURRENT_STATE.WRITING CURRENT_STATE.ADDRESSING CURRENT_STATE.READING CURRENT_STATE.WAIT_FOR_READING CURRENT_STATE.WAITING 
CURRENT_STATE.WAITING 0 0 0 0 0 0 0 0 
CURRENT_STATE.WAIT_FOR_READING 0 0 0 0 0 0 1 1 
CURRENT_STATE.READING 0 0 0 0 0 1 0 1 
CURRENT_STATE.ADDRESSING 0 0 0 0 1 0 0 1 
CURRENT_STATE.WRITING 0 0 0 1 0 0 0 1 
CURRENT_STATE.INCRPUT 0 0 1 0 0 0 0 1 
CURRENT_STATE.INCRGET 0 1 0 0 0 0 0 1 
CURRENT_STATE.COMPLETED 1 0 0 0 0 0 0 1 
